dgdimick/ARC-164-DCS-Display/PCBs/v1.0-Prototype/LED-Subboard/README.md

# ARC-164 LED Sub Board — Version 1.0 withdrawn; current version 1.2 published

**Last updated: November 10, 2026 at 6:01 PM MST (America/Denver)**

**LED Sub Board v1.2 is now published for Main Board v1.2.** I printed the latest mockup at **100%** and it passed the fit test, including **frequency and channel LED alignment and J20 connector/cable clearance**. The final layout keeps the **FREQ LEDs up 0.5 mm**, the **channel LEDs up 0.5 mm with their earlier 0.5 mm leftward adjustment**, and **J20 up 2 mm total** from the previous mounting position. The **0.75 mm gaps, 6 mm display bodies and tested 8 mm mounting stack** remain unchanged. **Use Main Board v1.2 with LED Sub Board v1.2; older Sub Boards do not match this Main Board. Assembled electrical testing is still pending.**

The older files remain withdrawn. Use [Sub Board v1.2](../../v1.2/LED-Subboard/README.md), which matches Main Board v1.2 and has passed physical mockup fitting.

[PCB status and available boards](../../README.md)
