dgdimick/ARC-164-DCS-Display/PCBs/v1.0-Prototype/LED-Subboard/Manufacturing/Drill-Report.txt

Drill report for LED Subboard.kicad_pcb
Created on 2026-11-07T11:51:38

Copper Layer Stackup:
    =============================================================
    L1 :  F.Cu                      front
    L2 :  B.Cu                      back

Drill file 'LED Subboard-PTH.drl' contains
    plated through holes:
    =============================================================
    T1  0.300mm  0.0118"  (83 holes))
    T2  1.000mm  0.0394"  (120 holes))

    Total plated holes count 203

Drill file 'LED Subboard-NPTH.drl' contains
    unplated through holes:
    =============================================================

    Total unplated holes count 0
