dgdimick/ARC-164-DCS-Display/PCBs/v1.0-Prototype/Main-Board/Manufacturing/Drill-Report.txt

Drill report for Main Board.kicad_pcb
Created on 2026-11-07T12:05:29

Copper Layer Stackup:
    =============================================================
    L1 :  F.Cu                      front
    L2 :  B.Cu                      back

Drill file 'Main Board-PTH.drl' contains
    plated through holes:
    =============================================================
    T1  0.300mm  0.0118"  (20 holes))
    T2  0.800mm  0.0315"  (38 holes))
    T3  0.900mm  0.0354"  (38 holes))
    T4  1.000mm  0.0394"  (78 holes))
    T5  1.500mm  0.0591"  (18 holes))
    T6  1.700mm  0.0669"  (12 holes))
    T7  2.000mm  0.0787"  (14 holes)  (with 14 slots)

    Total plated holes count 218

Drill file 'Main Board-NPTH.drl' contains
    unplated through holes:
    =============================================================

    Total unplated holes count 0
