dgdimick/ARC-164-DCS-Display/PCBs/v1.0-Prototype/Power-Driver-Board/Manufacturing/Drill-Report.txt

Drill report for Power Driver Board.kicad_pcb
Created on 2026-11-07T11:51:38

Copper Layer Stackup:
    =============================================================
    L1 :  F.Cu                      front
    L2 :  B.Cu                      back

Drill file 'Power Driver Board-PTH.drl' contains
    plated through holes:
    =============================================================
    T1  0.300mm  0.0118"  (54 holes))
    T2  0.800mm  0.0315"  (96 holes))
    T3  1.000mm  0.0394"  (83 holes))
    T4  1.100mm  0.0433"  (62 holes))
    T5  1.600mm  0.0630"  (3 holes))

    Total plated holes count 298

Drill file 'Power Driver Board-NPTH.drl' contains
    unplated through holes:
    =============================================================
    T1  3.200mm  0.1260"  (2 holes)  (with 2 slots)

    Total unplated holes count 2
