dgdimick/ARC-164-DCS-Display/images/ARC-164-MAIN-PRESET-height-preview.png

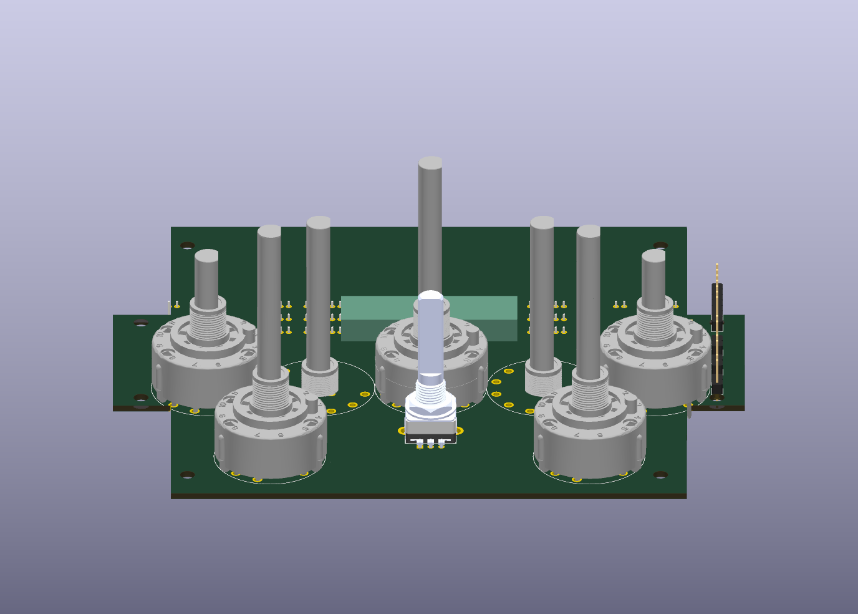
images/ARC-164-MAIN-PRESET-height-preview.png
