dgdimick/ARC-164-DCS-Display/images/ARC-164_Staggered_PCB_Mount_Concept.png

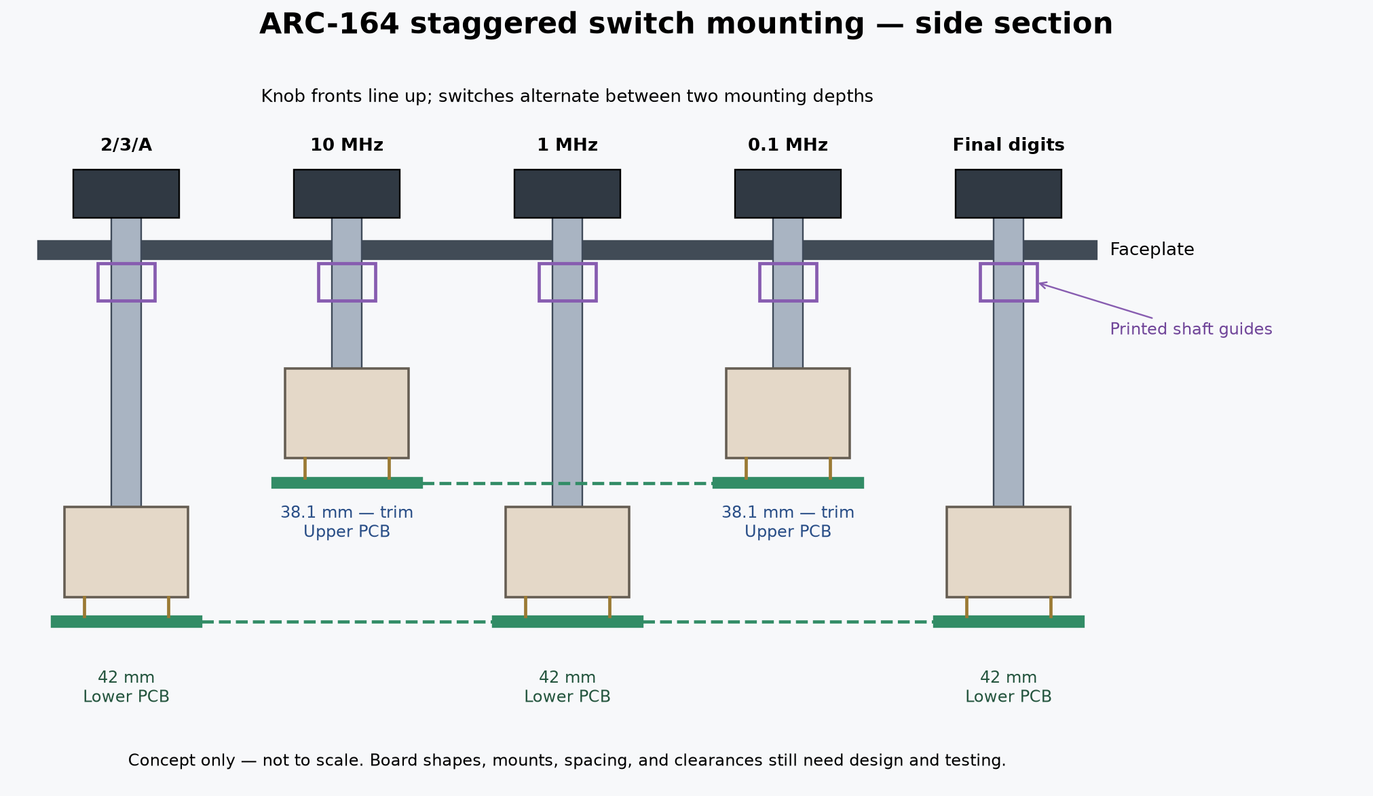
images/ARC-164_Staggered_PCB_Mount_Concept.png
