dgdimick/ARC-164-DCS-Display/images/ARC-164_Switch_PCB_Fit_Check.png

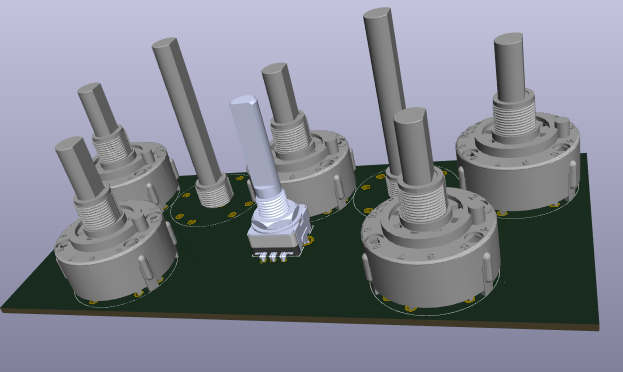
images/ARC-164_Switch_PCB_Fit_Check.png
