dgdimick/ARC-164-DCS-Display/images/PC-Flights-Six-Digit-Amber-Display-Drawing.png

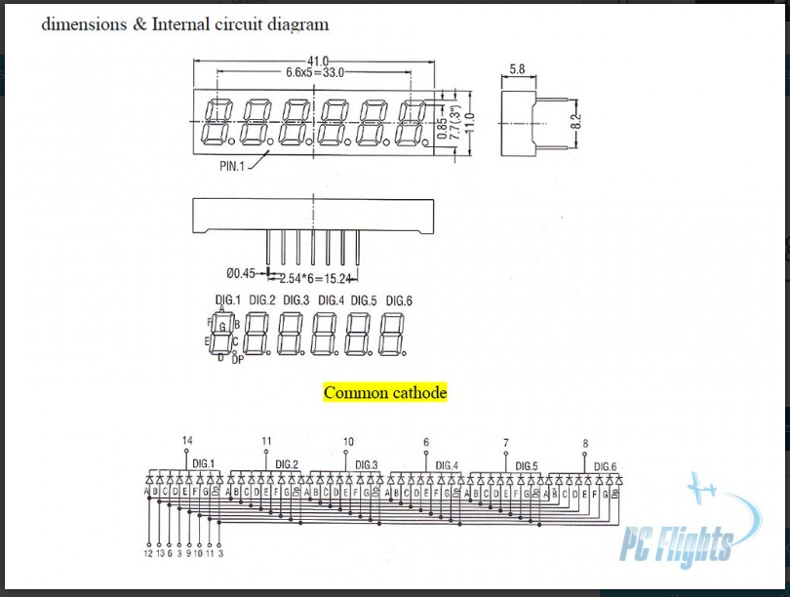
images/PC-Flights-Six-Digit-Amber-Display-Drawing.png
