dgdimick/ARC-164-DCS-Display/PCBs/v1.0-Prototype/LED-Subboard/Previews/bottom.png

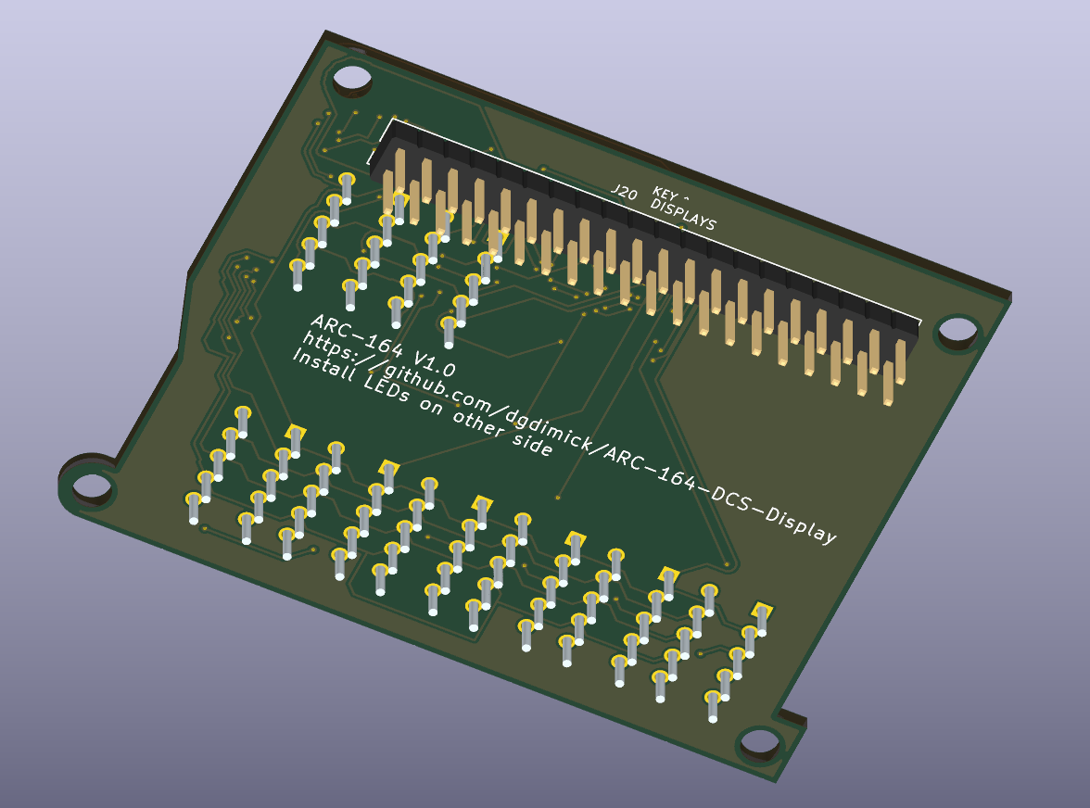
PCBs/v1.0-Prototype/LED-Subboard/Previews/bottom.png
