dgdimick/ARC-164-DCS-Display/PCBs/v1.0-Prototype/LED-Subboard/Previews/top.png

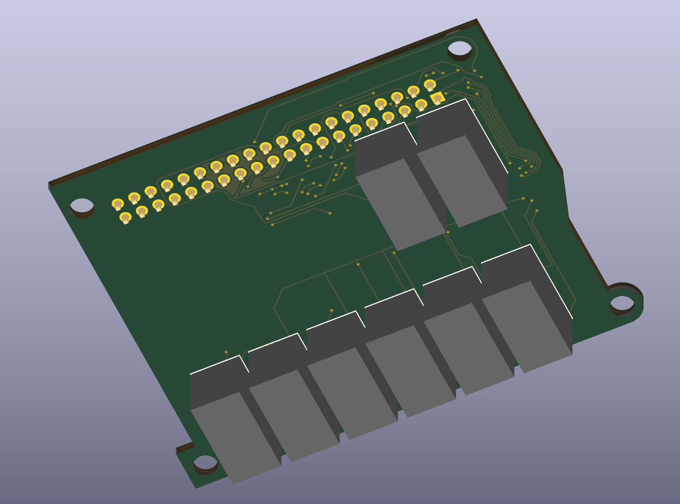
PCBs/v1.0-Prototype/LED-Subboard/Previews/top.png
