dgdimick/ARC-164-DCS-Display/PCBs/v1.0-Prototype/Main-Board/Previews/bottom.png

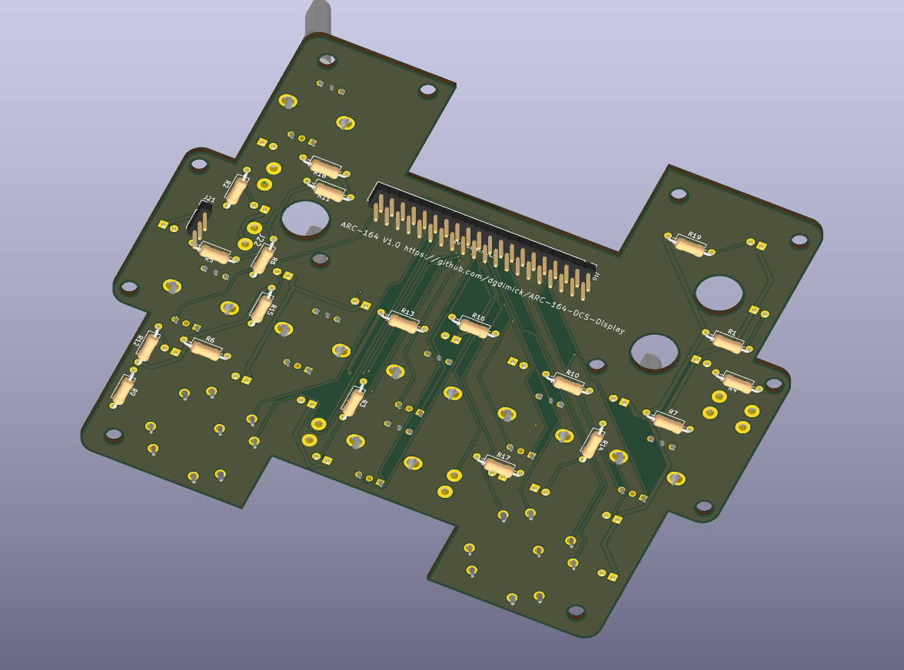
PCBs/v1.0-Prototype/Main-Board/Previews/bottom.png
