dgdimick/ARC-164-DCS-Display/PCBs/v1.2/LED-Subboard/Assembly/BOM.csv

Refs | Value | Footprint | Qty | DNP
DS1 | QBSLDIW301GR | ARC164_WhiteDisplays:QBSLDIW301GR | 1
DS2 | QBSLDIW301GR | ARC164_WhiteDisplays:QBSLDIW301GR | 1
DS3 | QBSLDIW301GR | ARC164_WhiteDisplays:QBSLDIW301GR | 1
DS4 | QBSLDIW301GR | ARC164_WhiteDisplays:QBSLDIW301GR | 1
DS5 | QBSLDIW301GR | ARC164_WhiteDisplays:QBSLDIW301GR | 1
DS6 | QBSLDIW301GR | ARC164_WhiteDisplays:QBSLDIW301GR | 1
DS7 | QBSLDIW301GR | ARC164_WhiteDisplays:QBSLDIW301GR | 1
DS8 | QBSLDIW301GR | ARC164_WhiteDisplays:QBSLDIW301GR | 1
J20 | TSW-120-07-L-D - DISPLAYS | Connector_PinHeader_2.54mm:PinHeader_2x20_P2.54mm_Vertical | 1
