dgdimick/ARC-164-DCS-Display/PCBs/v1.2/Main-Board/Assembly/BOM.csv

Refs | Value | Footprint | Qty | DNP
D1 | WP710A10SGD | ARC164_Backlight:LED_D3.0mm_Green | 1
D2 | WP710A10SGD | ARC164_Backlight:LED_D3.0mm_Green | 1
D3 | WP710A10SGD | ARC164_Backlight:LED_D3.0mm_Green | 1
D4 | WP710A10SGD | ARC164_Backlight:LED_D3.0mm_Green | 1
D5 | WP710A10SGD | ARC164_Backlight:LED_D3.0mm_Green | 1
D6 | WP710A10SGD | ARC164_Backlight:LED_D3.0mm_Green | 1
D7 | WP710A10SGD | ARC164_Backlight:LED_D3.0mm_Green | 1
D8 | WP710A10SGD | ARC164_Backlight:LED_D3.0mm_Green | 1
D9 | WP710A10SGD | ARC164_Backlight:LED_D3.0mm_Green | 1
D10 | WP710A10SGD | ARC164_Backlight:LED_D3.0mm_Green | 1
D11 | WP710A10SGD | ARC164_Backlight:LED_D3.0mm_Green | 1
D12 | WP710A10SGD | ARC164_Backlight:LED_D3.0mm_Green | 1
D13 | WP710A10SGD | ARC164_Backlight:LED_D3.0mm_Green | 1
D14 | WP710A10SGD | ARC164_Backlight:LED_D3.0mm_Green | 1
D15 | WP710A10SGD | ARC164_Backlight:LED_D3.0mm_Green | 1
D16 | WP710A10SGD | ARC164_Backlight:LED_D3.0mm_Green | 1
D17 | WP710A10SGD | ARC164_Backlight:LED_D3.0mm_Green | 1
D18 | WP710A10SGD | ARC164_Backlight:LED_D3.0mm_Green | 1
D19 | WP710A10SGD | ARC164_Backlight:LED_D3.0mm_Green | 1
J10 | Controls cable to Power Driver Board J10 | Connector_PinHeader_2.54mm:PinHeader_2x20_P2.54mm_Vertical | 1
J21 | Backlight power from driver J21 | Connector_PinHeader_2.54mm:PinHeader_1x03_P2.54mm_Vertical | 1
J22 | Auxiliary resistor-limited backlight output | ARC164_WirePads:WireSolderPads_1x02_P4.6mm_D1.7mm_18AWG | 1
R1 | 330 | Resistor_THT:R_Axial_DIN0207_L6.3mm_D2.5mm_P10.16mm_Horizontal | 1
R2 | 330 | Resistor_THT:R_Axial_DIN0207_L6.3mm_D2.5mm_P10.16mm_Horizontal | 1
R3 | 330 | Resistor_THT:R_Axial_DIN0207_L6.3mm_D2.5mm_P10.16mm_Horizontal | 1
R4 | 330 | Resistor_THT:R_Axial_DIN0207_L6.3mm_D2.5mm_P10.16mm_Horizontal | 1
R5 | 330 | Resistor_THT:R_Axial_DIN0207_L6.3mm_D2.5mm_P10.16mm_Horizontal | 1
R6 | 330 | Resistor_THT:R_Axial_DIN0207_L6.3mm_D2.5mm_P10.16mm_Horizontal | 1
R7 | 330 | Resistor_THT:R_Axial_DIN0207_L6.3mm_D2.5mm_P10.16mm_Horizontal | 1
R8 | 330 | Resistor_THT:R_Axial_DIN0207_L6.3mm_D2.5mm_P10.16mm_Horizontal | 1
R9 | 330 | Resistor_THT:R_Axial_DIN0207_L6.3mm_D2.5mm_P10.16mm_Horizontal | 1
R10 | 330 | Resistor_THT:R_Axial_DIN0207_L6.3mm_D2.5mm_P10.16mm_Horizontal | 1
R11 | 330 | Resistor_THT:R_Axial_DIN0207_L6.3mm_D2.5mm_P10.16mm_Horizontal | 1
R12 | 330 | Resistor_THT:R_Axial_DIN0207_L6.3mm_D2.5mm_P10.16mm_Horizontal | 1
R13 | 330 | Resistor_THT:R_Axial_DIN0207_L6.3mm_D2.5mm_P10.16mm_Horizontal | 1
R14 | 330 | Resistor_THT:R_Axial_DIN0207_L6.3mm_D2.5mm_P10.16mm_Horizontal | 1
R15 | 330 | Resistor_THT:R_Axial_DIN0207_L6.3mm_D2.5mm_P10.16mm_Horizontal | 1
R16 | 330 | Resistor_THT:R_Axial_DIN0207_L6.3mm_D2.5mm_P10.16mm_Horizontal | 1
R17 | 330 | Resistor_THT:R_Axial_DIN0207_L6.3mm_D2.5mm_P10.16mm_Horizontal | 1
R18 | 330 | Resistor_THT:R_Axial_DIN0207_L6.3mm_D2.5mm_P10.16mm_Horizontal | 1
R19 | 330 | Resistor_THT:R_Axial_DIN0207_L6.3mm_D2.5mm_P10.16mm_Horizontal | 1
SW1 | PEC11R-4230F-S0024 | ARC210_Encoders:PEC11R4230FS0024 | 1
SW2 | PEC11R-4230F-S0024 | ARC210_Encoders:PEC11R4230FS0024 | 1
SW3 | PEC11R-4230F-S0024 | ARC210_Encoders:PEC11R4230FS0024 | 1
SW4 | PEC11R-4230F-S0024 | ARC210_Encoders:PEC11R4230FS0024 | 1
SW5 | PEC11R-4230F-S0024 | ARC210_Encoders:PEC11R4230FS0024 | 1
SW6 | PEC11R-4230F-S0024 | ARC210_Encoders:PEC11R4230FS0024 | 1
SW7 | A12505RNCQ | ARC164_Switches:A12505RNCQ | 1
SW8 | A12505RNCQ | ARC164_Switches:A12505RNCQ | 1
SW9 | PEC11R-4230F-S0024 | ARC210_Encoders:PEC11R4230FS0024 | 1
SW10 | TONE - wire solder pads | ARC164_WirePads:WireSolderPads_1x02_P4.6mm_D1.7mm_18AWG | 1
SW11 | SQL - wire solder pads | ARC164_WirePads:WireSolderPads_1x02_P4.6mm_D1.7mm_18AWG | 1
SW12 | LOAD (magnetic reed) - wire solder pads | ARC164_WirePads:WireSolderPads_1x02_P4.6mm_D1.7mm_18AWG | 1
SW13 | TEST_DISPLAY - wire solder pads | ARC164_WirePads:WireSolderPads_1x02_P4.6mm_D1.7mm_18AWG | 1
SW14 | STATUS - wire solder pads | ARC164_WirePads:WireSolderPads_1x02_P4.6mm_D1.7mm_18AWG | 1
