dgdimick/ARC-164-DCS-Display/PCBs/v1.0-Prototype/LED-Subboard/Assembly/BOM.csv

Refs | Value | Footprint | Qty | DNP
DS1-DS6 | SC36-11SURKWA | Kingbright_SC36:SC3611SURKWA_Frequency | 6
DS7,DS8 | SC36-11SURKWA | Kingbright_SC36:SC3611SURKWA | 2
J20 | TSW-120-07-L-D - DISPLAYS | Connector_PinHeader_2.54mm:PinHeader_2x20_P2.54mm_Vertical | 1
