dgdimick/ARC-164-DCS-Display/PCBs/v1.0-Prototype/Main-Board/Assembly/BOM.csv

Refs | Value | Footprint | Qty | DNP
D1-D19 | WP710A10SGD | ARC164_Backlight:LED_D3.0mm_Green | 19
J10 | Controls cable to Power Driver Board J10 | Connector_PinHeader_2.54mm:PinHeader_2x20_P2.54mm_Vertical | 1
J21 | Backlight power from driver J21 | Connector_PinHeader_2.54mm:PinHeader_1x03_P2.54mm_Vertical | 1
J22 | Auxiliary resistor-limited backlight output | ARC164_WirePads:WireSolderPads_1x02_P4.6mm_D1.7mm_18AWG | 1
R1-R19 | 330 | Resistor_THT:R_Axial_DIN0207_L6.3mm_D2.5mm_P10.16mm_Horizontal | 19
SW1-SW6,SW9 | PEC11R-4230F-S0024 | ARC210_Encoders:PEC11R4230FS0024 | 7
SW7,SW8 | A12505RNCQ | ARC164_Switches:A12505RNCQ | 2
SW10 | TONE - wire solder pads | ARC164_WirePads:WireSolderPads_1x02_P4.6mm_D1.7mm_18AWG | 1
SW11 | SQL - wire solder pads | ARC164_WirePads:WireSolderPads_1x02_P4.6mm_D1.7mm_18AWG | 1
SW12 | LOAD (magnetic reed) - wire solder pads | ARC164_WirePads:WireSolderPads_1x02_P4.6mm_D1.7mm_18AWG | 1
SW13 | TEST_DISPLAY - wire solder pads | ARC164_WirePads:WireSolderPads_1x02_P4.6mm_D1.7mm_18AWG | 1
SW14 | STATUS - wire solder pads | ARC164_WirePads:WireSolderPads_1x02_P4.6mm_D1.7mm_18AWG | 1
