dgdimick/ARC-164-DCS-Display/PCBs/v1.0-Prototype/Power-Driver-Board/Assembly/BOM.csv

Refs | Value | Footprint | Qty | DNP
C11,C13,C15 | 100nF | Capacitor_THT:C_Disc_D5.0mm_W2.5mm_P5.00mm | 3
C12,C14 | 10uF / 10V | Capacitor_THT:CP_Radial_D5.0mm_P2.00mm | 2
J10 | Controls cable to Main Board J10 | Connector_PinHeader_2.54mm:PinHeader_2x20_P2.54mm_Vertical | 1
J11 | PJ-102AH | 5V ONLY, center + | ARC164_Power:BarrelJack_CUI_PJ-102AH_Horizontal | 1
J20 | TSW-120-07-L-D - DISPLAYS | Connector_PinHeader_2.54mm:PinHeader_2x20_P2.54mm_Vertical | 1
J21 | Backlight power to Main Board J21 | Connector_PinHeader_2.54mm:PinHeader_1x03_P2.54mm_Vertical | 1
Q1 | IRLZ44N | Package_TO_SOT_THT:TO-220-3_Vertical | 1
R11,R12 | 68k | Resistor_THT:R_Axial_DIN0207_L6.3mm_D2.5mm_P10.16mm_Horizontal | 2
R13 | 220 | Resistor_THT:R_Axial_DIN0207_L6.3mm_D2.5mm_P10.16mm_Horizontal | 1
R14,R21-R24 | 100k | Resistor_THT:R_Axial_DIN0207_L6.3mm_D2.5mm_P10.16mm_Horizontal | 5
U1 | Teensy 4.1 - USB powered | teensy:Teensy41 | 1
U11,U12 | MAX7219 | Package_DIP:DIP-24_W7.62mm | 2
U13 | 74AHCT125 | Package_DIP:DIP-14_W7.62mm | 1
