dgdimick/ARC-164-DCS-Display/PCBs/v1.0-Prototype/Docs/Connector-Pin-Comparison.csv

Connector | Pin | Board A | Signal A | Board B | Signal B | Match
J10 | 1 | main | GND | power | GND | True
J10 | 2 | main | NC | power | NC | True
J10 | 3 | main | NC | power | NC | True
J10 | 4 | main | NC | power | NC | True
J10 | 5 | main | NC | power | NC | True
J10 | 6 | main | FREQ1_A | power | FREQ1_A | True
J10 | 7 | main | FREQ1_B | power | FREQ1_B | True
J10 | 8 | main | FREQ2_A | power | FREQ2_A | True
J10 | 9 | main | FREQ2_B | power | FREQ2_B | True
J10 | 10 | main | FREQ3_A | power | FREQ3_A | True
J10 | 11 | main | FREQ3_B | power | FREQ3_B | True
J10 | 12 | main | FREQ4_A | power | FREQ4_A | True
J10 | 13 | main | FREQ4_B | power | FREQ4_B | True
J10 | 14 | main | FREQ5_A | power | FREQ5_A | True
J10 | 15 | main | FREQ5_B | power | FREQ5_B | True
J10 | 16 | main | CHANNEL_A | power | CHANNEL_A | True
J10 | 17 | main | CHANNEL_B | power | CHANNEL_B | True
J10 | 18 | main | VOL_A | power | VOL_A | True
J10 | 19 | main | VOL_B | power | VOL_B | True
J10 | 20 | main | MAIN_POS1 | power | MAIN_POS1 | True
J10 | 21 | main | MAIN_POS2 | power | MAIN_POS2 | True
J10 | 22 | main | MAIN_POS3 | power | MAIN_POS3 | True
J10 | 23 | main | MAIN_POS4 | power | MAIN_POS4 | True
J10 | 24 | main | PRESET_POS1 | power | PRESET_POS1 | True
J10 | 25 | main | PRESET_POS2 | power | PRESET_POS2 | True
J10 | 26 | main | PRESET_POS3 | power | PRESET_POS3 | True
J10 | 27 | main | TONE | power | TONE | True
J10 | 28 | main | SQL | power | SQL | True
J10 | 29 | main | LOAD | power | LOAD | True
J10 | 30 | main | TEST_DISPLAY | power | TEST_DISPLAY | True
J10 | 31 | main | STATUS | power | STATUS | True
J10 | 32 | main | GND | power | GND | True
J10 | 33 | main | NC | power | NC | True
J10 | 34 | main | NC | power | NC | True
J10 | 35 | main | NC | power | NC | True
J10 | 36 | main | NC | power | NC | True
J10 | 37 | main | NC | power | NC | True
J10 | 38 | main | NC | power | NC | True
J10 | 39 | main | NC | power | NC | True
J10 | 40 | main | NC | power | NC | True
J20 | 1 | power | SEG1_A | led | SEG1_A | True
J20 | 2 | power | SEG1_B | led | SEG1_B | True
J20 | 3 | power | SEG1_C | led | SEG1_C | True
J20 | 4 | power | SEG1_D | led | SEG1_D | True
J20 | 5 | power | SEG1_E | led | SEG1_E | True
J20 | 6 | power | SEG1_F | led | SEG1_F | True
J20 | 7 | power | SEG1_G | led | SEG1_G | True
J20 | 8 | power | SEG1_DP | led | SEG1_DP | True
J20 | 9 | power | DIG1_0 | led | DIG1_0 | True
J20 | 10 | power | DIG1_1 | led | DIG1_1 | True
J20 | 11 | power | DIG1_2 | led | DIG1_2 | True
J20 | 12 | power | DIG1_3 | led | DIG1_3 | True
J20 | 13 | power | DIG1_4 | led | DIG1_4 | True
J20 | 14 | power | DIG1_5 | led | DIG1_5 | True
J20 | 15 | power | SEG2_A | led | SEG2_A | True
J20 | 16 | power | SEG2_B | led | SEG2_B | True
J20 | 17 | power | SEG2_C | led | SEG2_C | True
J20 | 18 | power | SEG2_D | led | SEG2_D | True
J20 | 19 | power | SEG2_E | led | SEG2_E | True
J20 | 20 | power | SEG2_F | led | SEG2_F | True
J20 | 21 | power | SEG2_G | led | SEG2_G | True
J20 | 22 | power | SEG2_DP | led | SEG2_DP | True
J20 | 23 | power | DIG2_0 | led | DIG2_0 | True
J20 | 24 | power | DIG2_1 | led | DIG2_1 | True
J20 | 25 | power | NC | led | NC | True
J20 | 26 | power | NC | led | NC | True
J20 | 27 | power | GND | led | GND | True
J20 | 28 | power | GND | led | GND | True
J20 | 29 | power | LED_5V | led | LED_5V | True
J20 | 30 | power | LED_5V | led | LED_5V | True
J20 | 31 | power | BACKLIGHT_RETURN | led | BACKLIGHT_RETURN | True
J20 | 32 | power | BACKLIGHT_RETURN | led | BACKLIGHT_RETURN | True
J20 | 33 | power | NC | led | NC | True
J20 | 34 | power | NC | led | NC | True
J20 | 35 | power | NC | led | NC | True
J20 | 36 | power | NC | led | NC | True
J20 | 37 | power | NC | led | NC | True
J20 | 38 | power | NC | led | NC | True
J20 | 39 | power | NC | led | NC | True
J20 | 40 | power | NC | led | NC | True
J21 | 1 | main | LED_5V | power | LED_5V | True
J21 | 2 | main | BACKLIGHT_RETURN | power | BACKLIGHT_RETURN | True
J21 | 3 | main | GND | power | GND | True
