dgdimick/ARC-164-DCS-Display/PCBs/v1.2/Main-Board/STLs/ARC-164_Main_Board_v1.2_100pct.stl

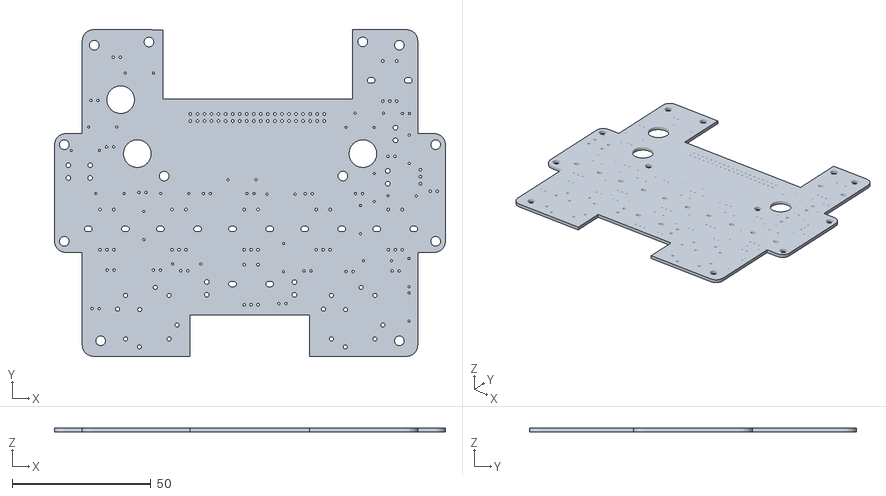
[picture p18: CAD file, 2026-11-10]
PCBs/v1.2/Main-Board/STLs/ARC-164_Main_Board_v1.2_100pct.stl
141.0 x 117.8 x 1.51
