dgdimick/ARC-164-DCS-Display/PCBs/v1.0-Prototype/LED-Subboard/Project/Models/SC36-11SURKWA.stp

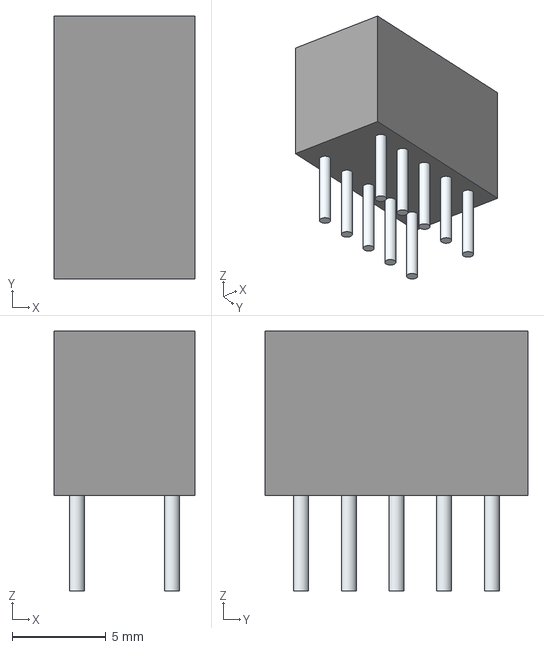
[picture p19: CAD file, 2026-11-07]
PCBs/v1.0-Prototype/LED-Subboard/Project/Models/SC36-11SURKWA.stp
7.50 x 14.0 x 13.8 mm
Leads
