dgdimick/ARC-164-DCS-Display/PCBs/v1.0-Prototype/Power-Driver-Board/Project/Models/PJ-102AH.step

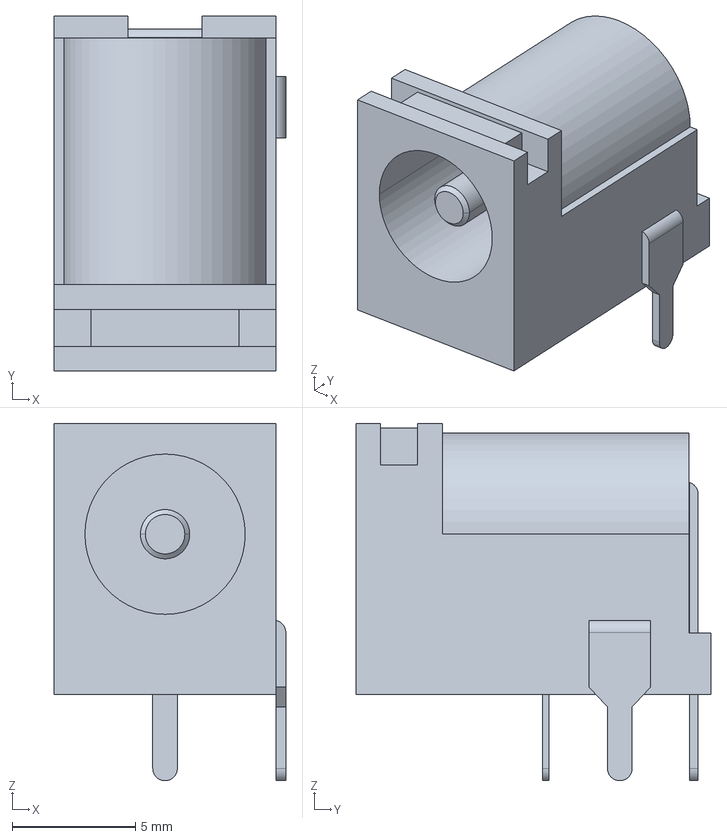
[picture p20: CAD file, 2026-11-07]
PCBs/v1.0-Prototype/Power-Driver-Board/Project/Models/PJ-102AH.step
9.40 x 14.4 x 14.5 mm
