dgdimick/ARC-164-DCS-Display/PCBs/v1.2/LED-Subboard/Project/Models/QBSLDIW301GR_MeasuredBody.step

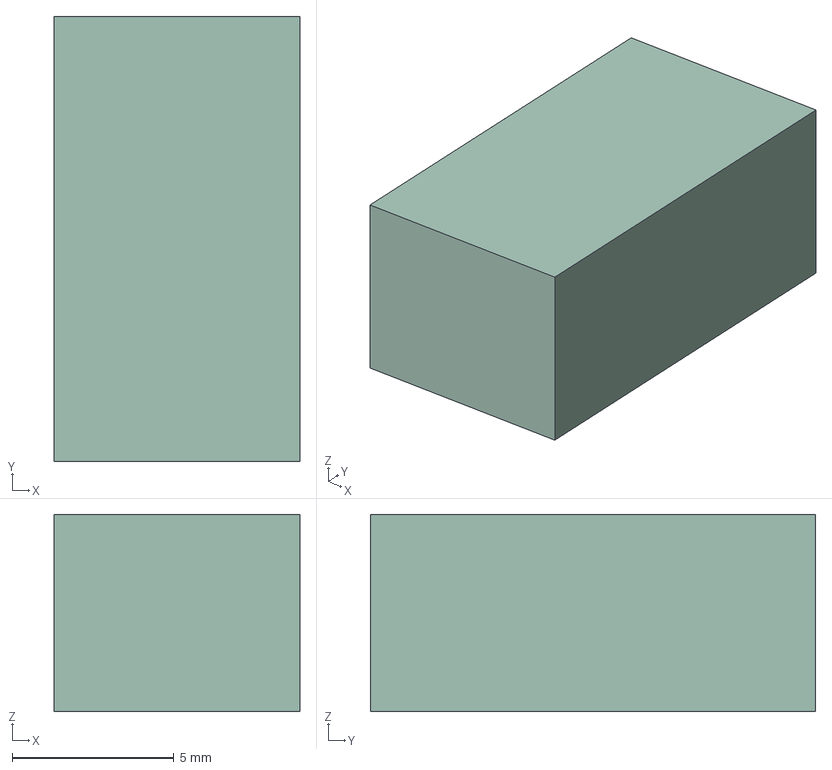
[picture p21: CAD file, 2026-11-11]
PCBs/v1.2/LED-Subboard/Project/Models/QBSLDIW301GR_MeasuredBody.step
7.60 x 13.8 x 6.10 mm
