dgdimick/ARC-164-DCS-Display/PCBs/v1.2/LED-Subboard/STLs/ARC-164_LED_Subboard_v1.2_100pct.stl

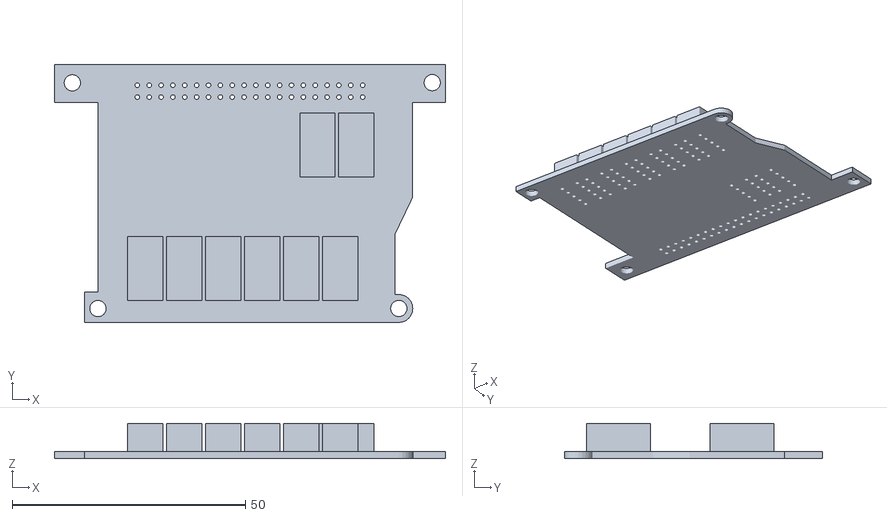
[picture p22: CAD file, 2026-11-11]
PCBs/v1.2/LED-Subboard/STLs/ARC-164_LED_Subboard_v1.2_100pct.stl
83.8 x 55.3 x 7.51
