dgdimick/ARC-164-DCS-Display/PCBs/v1.2/Main-Board/Project/Models/PEC11R-4230F-S0024-30mm-sizing.stp

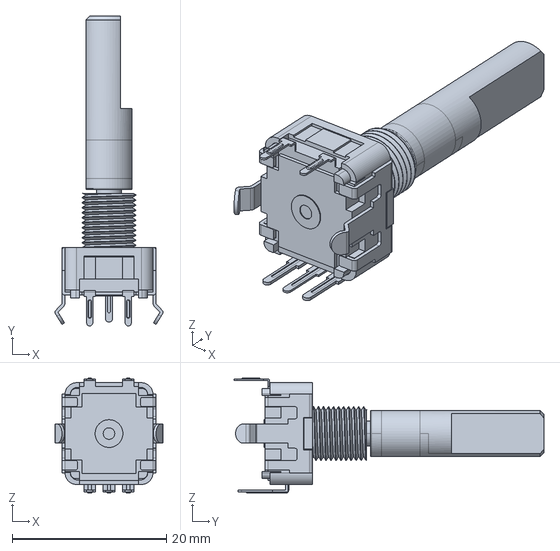
[picture p23: CAD file, 2026-11-10]
PCBs/v1.2/Main-Board/Project/Models/PEC11R-4230F-S0024-30mm-sizing.stp
14.0 x 40.2 x 14.9 mm
