dgdimick/ARC-164-DCS-Display/PCBs/v1.0-Prototype/Main-Board/Project/Models/A12505RNCQ.stp

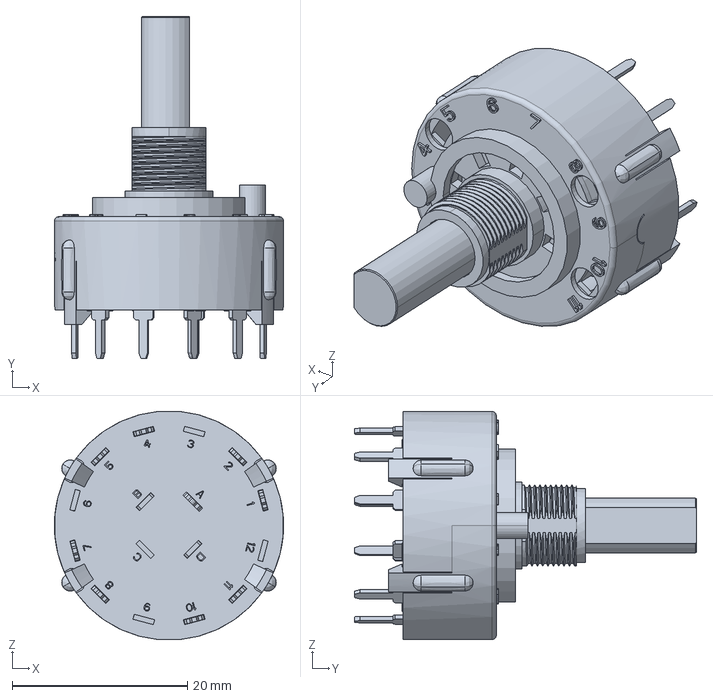
[picture p24: CAD file, 2026-11-07]
PCBs/v1.0-Prototype/Main-Board/Project/Models/A12505RNCQ.stp
26.2 x 39.1 x 26.1 mm
