dgdimick/ARC-164-DCS-Display/PCBs/v1.1/LED-Subboard/Project/Models/PEC11R-4220F-S0024-20mm-sizing.stp

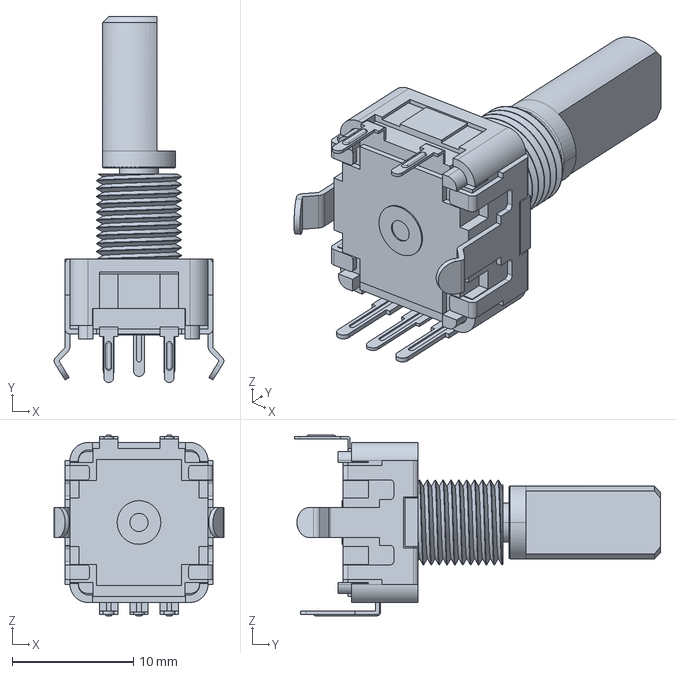
[picture p25: CAD file, 2026-11-08, an earlier design]
PCBs/v1.1/LED-Subboard/Project/Models/PEC11R-4220F-S0024-20mm-sizing.stp
14.0 x 30.2 x 14.9 mm
