dgdimick/ARC-164-DCS-Display/PCBs/v1.1/LED-Subboard/STLs/ARC-164_LED_Subboard_v1.1_100pct.stl

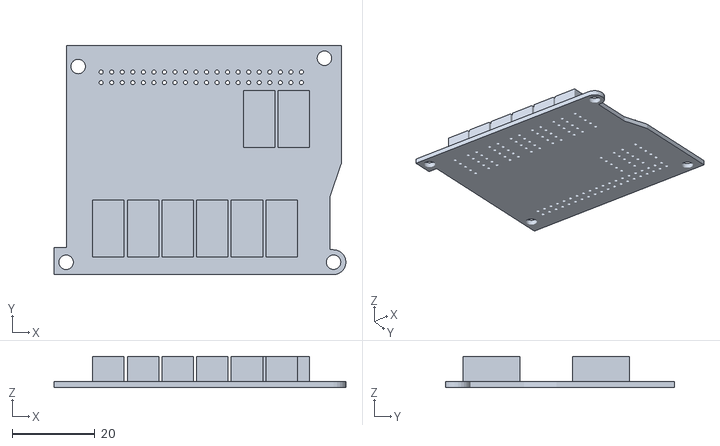
[picture p26: CAD file, 2026-11-08, an earlier design]
PCBs/v1.1/LED-Subboard/STLs/ARC-164_LED_Subboard_v1.1_100pct.stl
70.4 x 55.3 x 7.51
