dgdimick/ARC-164-DCS-Display/(list of files, cad)

Other CAD files:
PCBs/v1.1/Main-Board/STLs/ARC-164_Main_Board_v1.1_100pct.stl
PCBs/v1.1/Main-Board/Project/Models/A12505RNCQ.stp
