dgdimick/ARC-164-DCS-Display/PCBs/v1.2/LED-Subboard/Schematics/LED-Subboard-v1.2.pdf

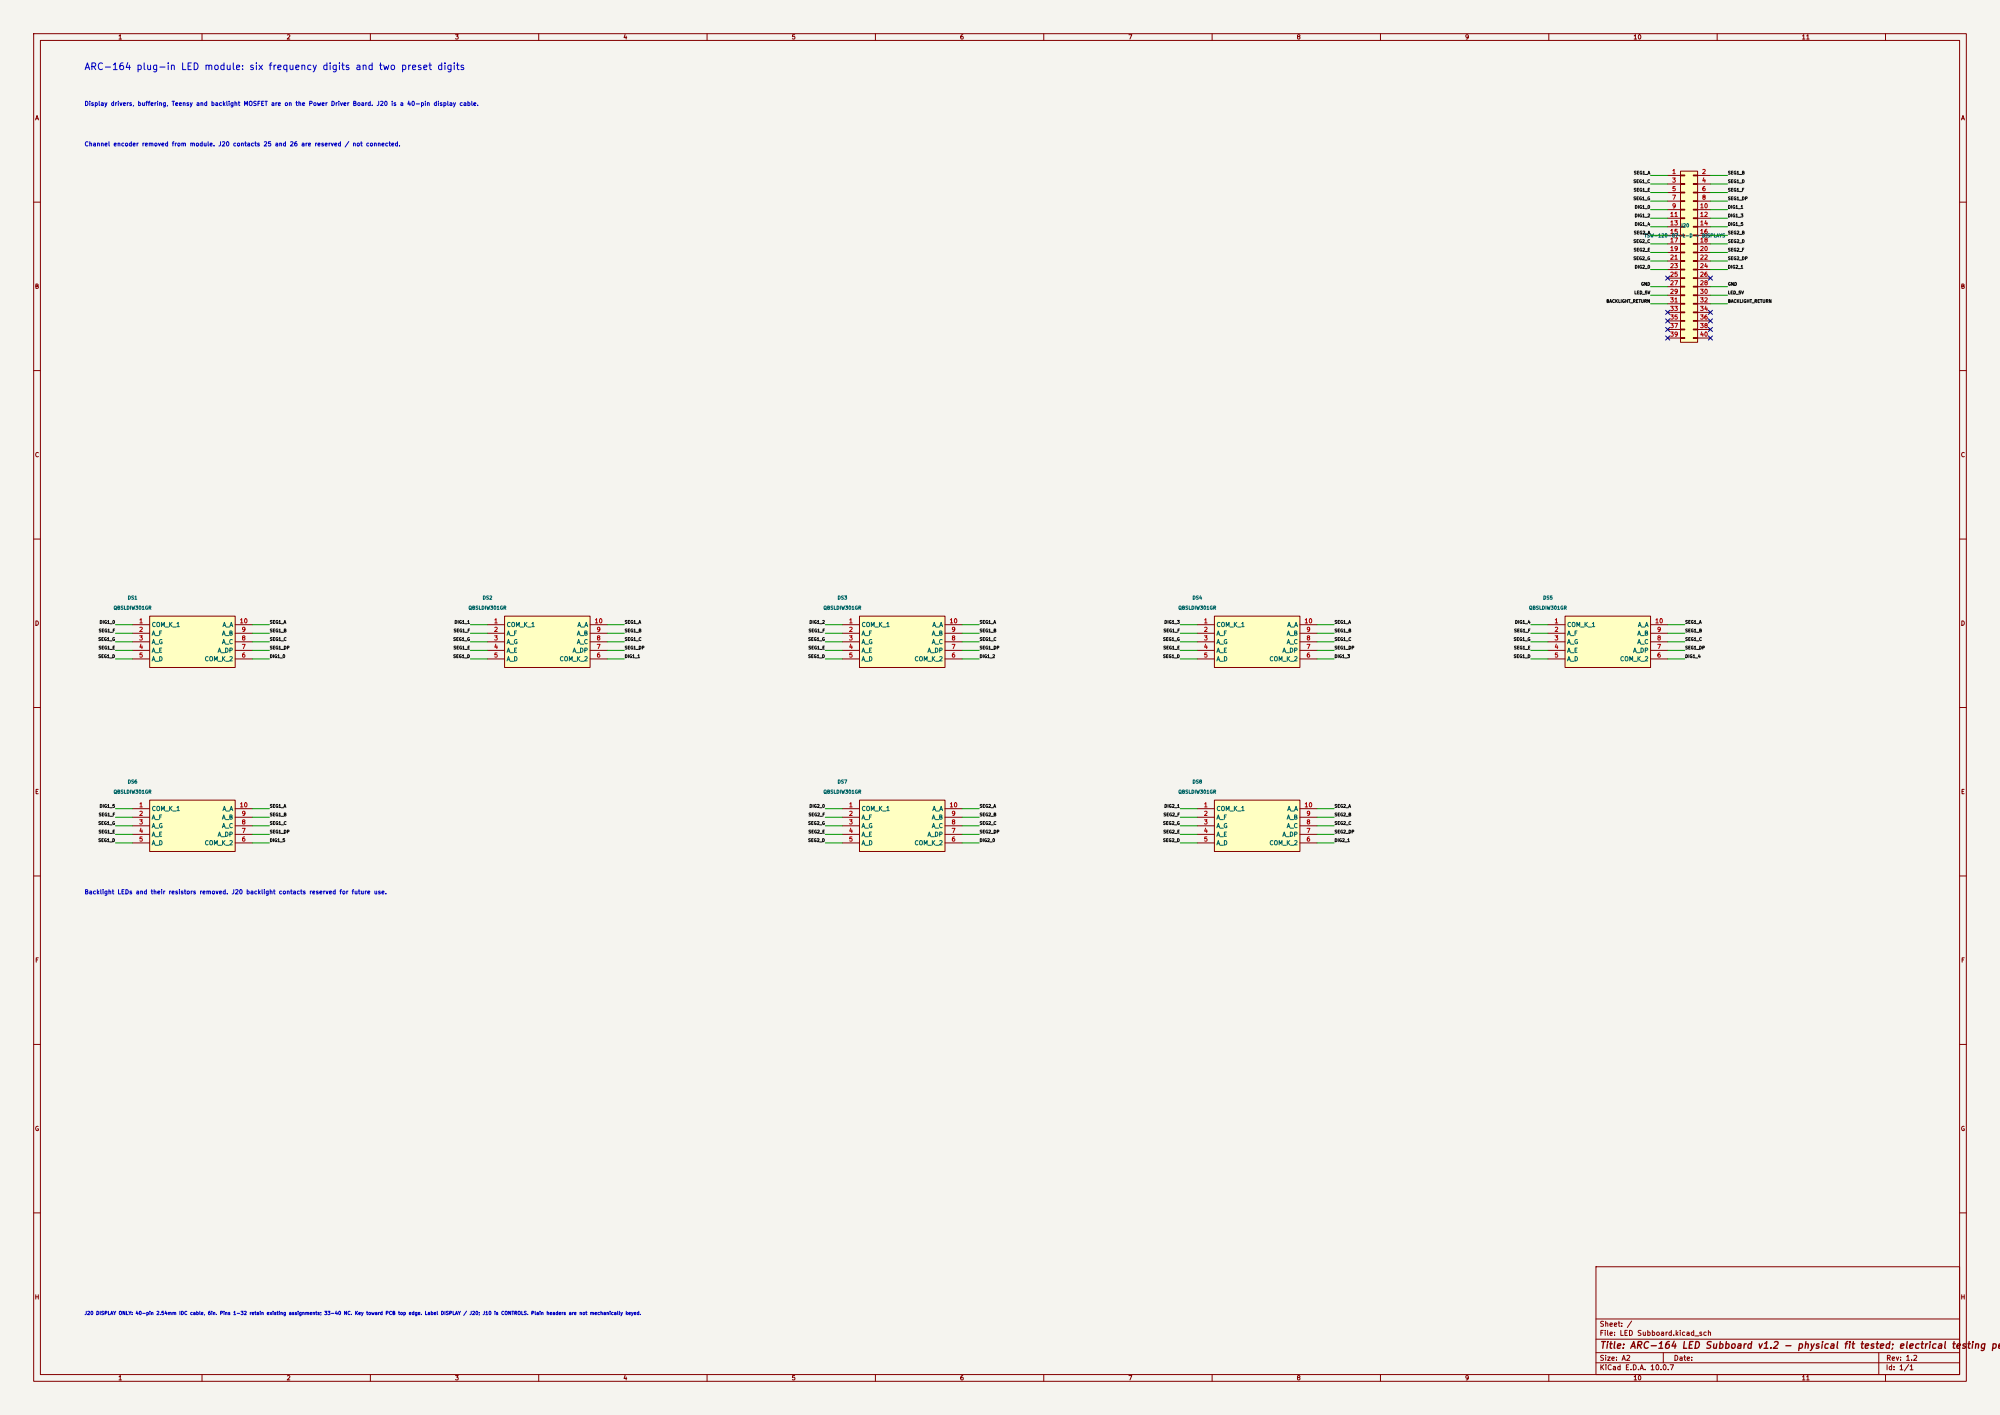
[picture p27: page 1]

ARC-164 plug-in LED module: six frequency digits and two preset digits

Display drivers, buffering, Teensy and backlight MOSFET are on the Power Driver Board. J20 is a 40-pin display cable. Channel encoder removed from module. J20 contacts 25 and 26 are reserved / not connected.

Backlight LEDs and their resistors removed. J20 backlight contacts reserved for future use.

J20 DISPLAY ONLY: 40-pin 2.54mm IDC cable, 6in. Pins 1-32 retain existing assignments; 33-40 NC. Key toward PCB top edge. Label DISPLAY / J20; J10 is CONTROLS. Plain headers are not mechanically keyed.

Sheet: /
File: LED Subboard.kicad_sch
Title: ARC-164 LED Subboard v1.2 - physical fit tested; electrical testing pending

Size: A2 | Rev: 1.2
KiCad E.D.A. 10.0.7 | Id: 1/1
