dgdimick/ARC-164-DCS-Display/PCBs/v1.2/Main-Board/Schematics/Main-Board-v1.2.pdf

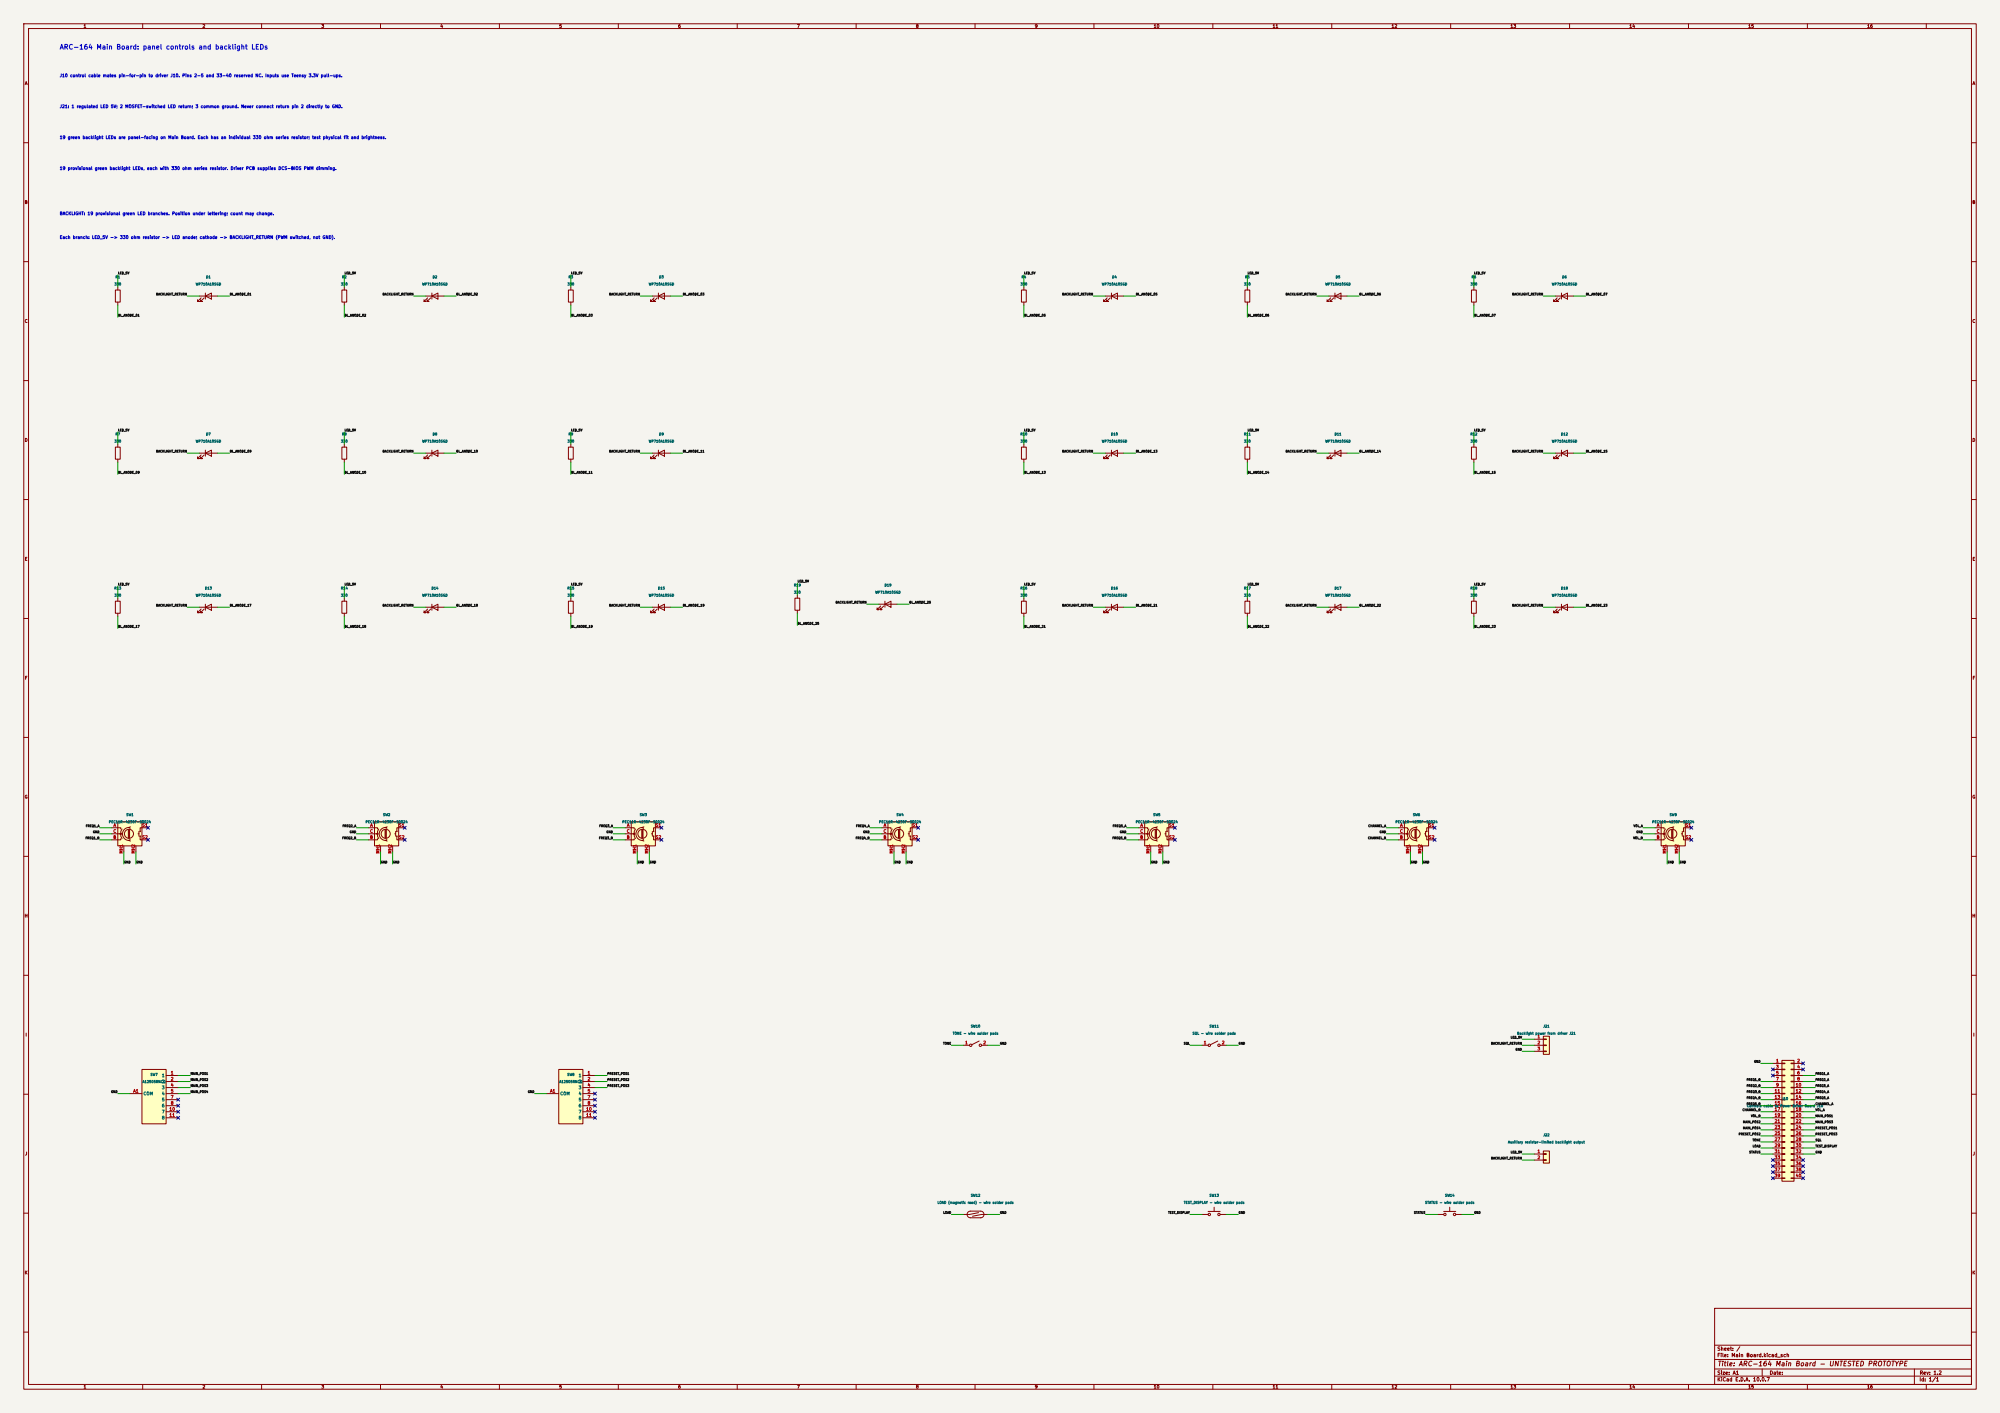
[picture p28: page 1]

ARC-164 Main Board: panel controls and backlight LEDs

J10 control cable mates pin-for-pin to driver J10. Pins 2-5 and 33-40 reserved NC. Inputs use Teensy 3.3V pull-ups. 19 provisional green backlight LEDs, each with 330 ohm series resistor. Driver PCB supplies DCS-BIOS PWM dimming. J21: 1 regulated LED 5V; 2 MOSFET-switched LED return; 3 common ground. Never connect return pin 2 directly to GND.

19 green backlight LEDs are panel-facing on Main Board. Each has an individual 330 ohm series resistor; test physical fit and brightness.

BACKLIGHT: 19 provisional green LED branches. Position under lettering; count may change. Each branch: LED_5V -> 330 ohm resistor -> LED anode; cathode -> BACKLIGHT_RETURN (PWM switched, not GND).

J21 Backlight power from driver J21

TONE - wire solder pads

SQL - wire solder pads

Auxiliary resistor-limited backlight output SW14

LOAD (magnetic reed) - wire solder pads

STATUS - wire solder pads

Sheet: /
File: Main Board.kicad_sch
Title: ARC-164 Main Board - UNTESTED PROTOTYPE

Size: A1 | Rev: 1.2
KiCad E.D.A. 10.0.7 | Id: 1/1
