dgdimick/ARC-164-DCS-Display/PCBs/v1.2/LED-Subboard/Project/LED Subboard.kicad_pcb

## KiCad design PCBs/v1.2/LED-Subboard/Project/LED Subboard.kicad_pcb (2026-11-11)

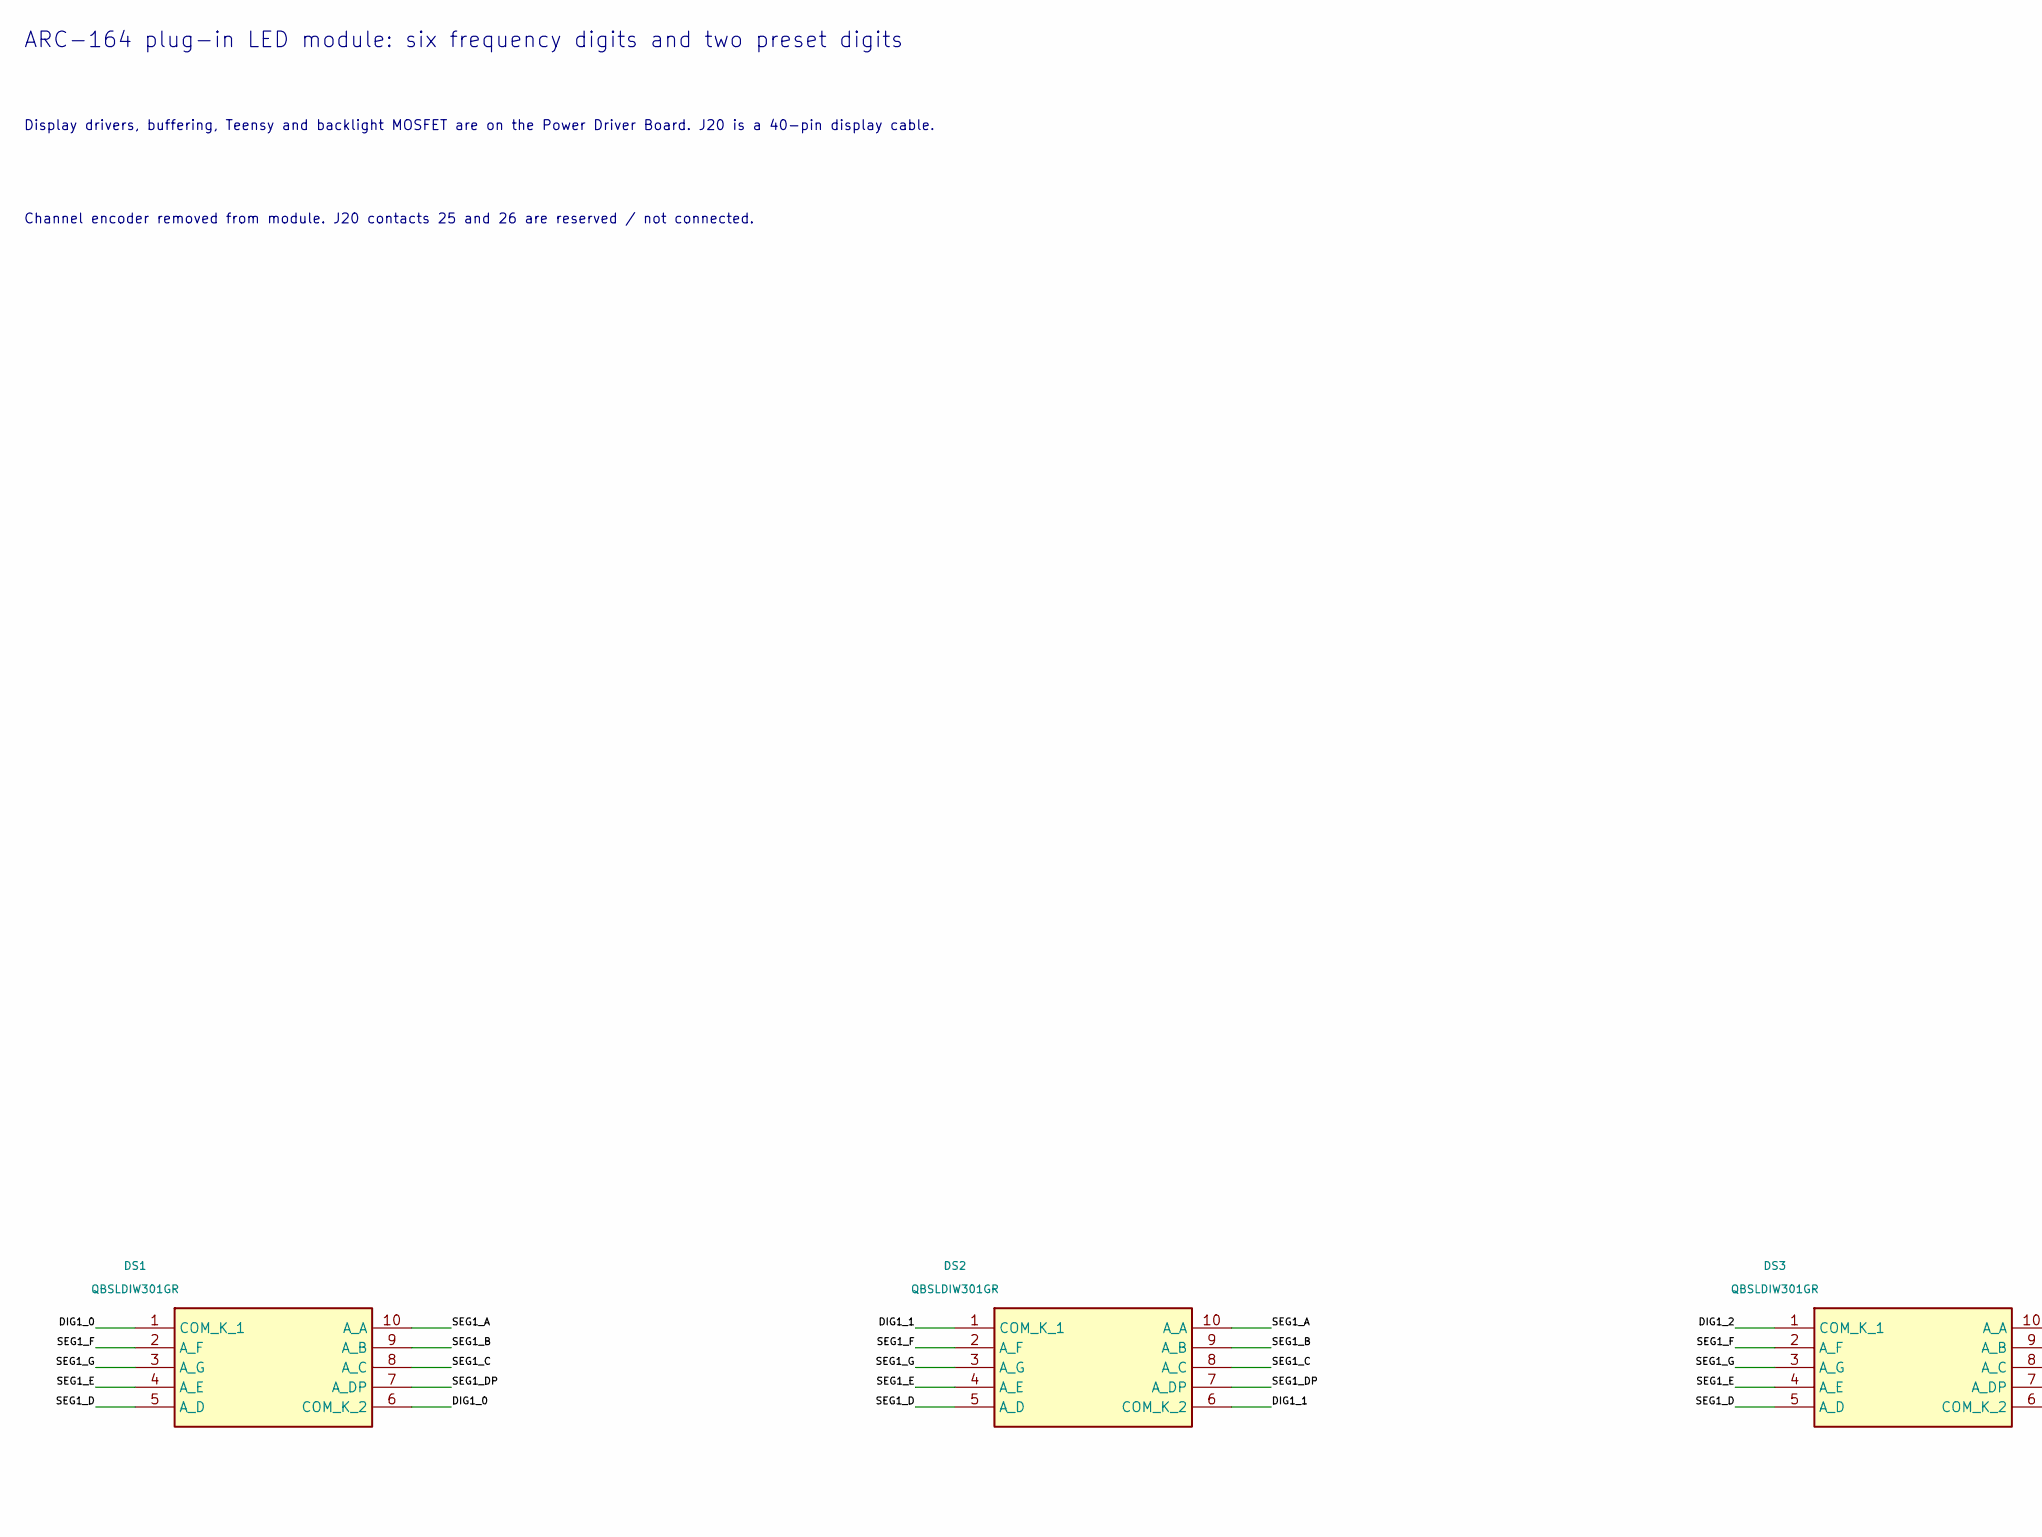
[picture p30: schematic LED Subboard.kicad_sch, ARC-164 LED Subboard v1.2 - physical fit tested; electrical…, part in row 1, column 1]

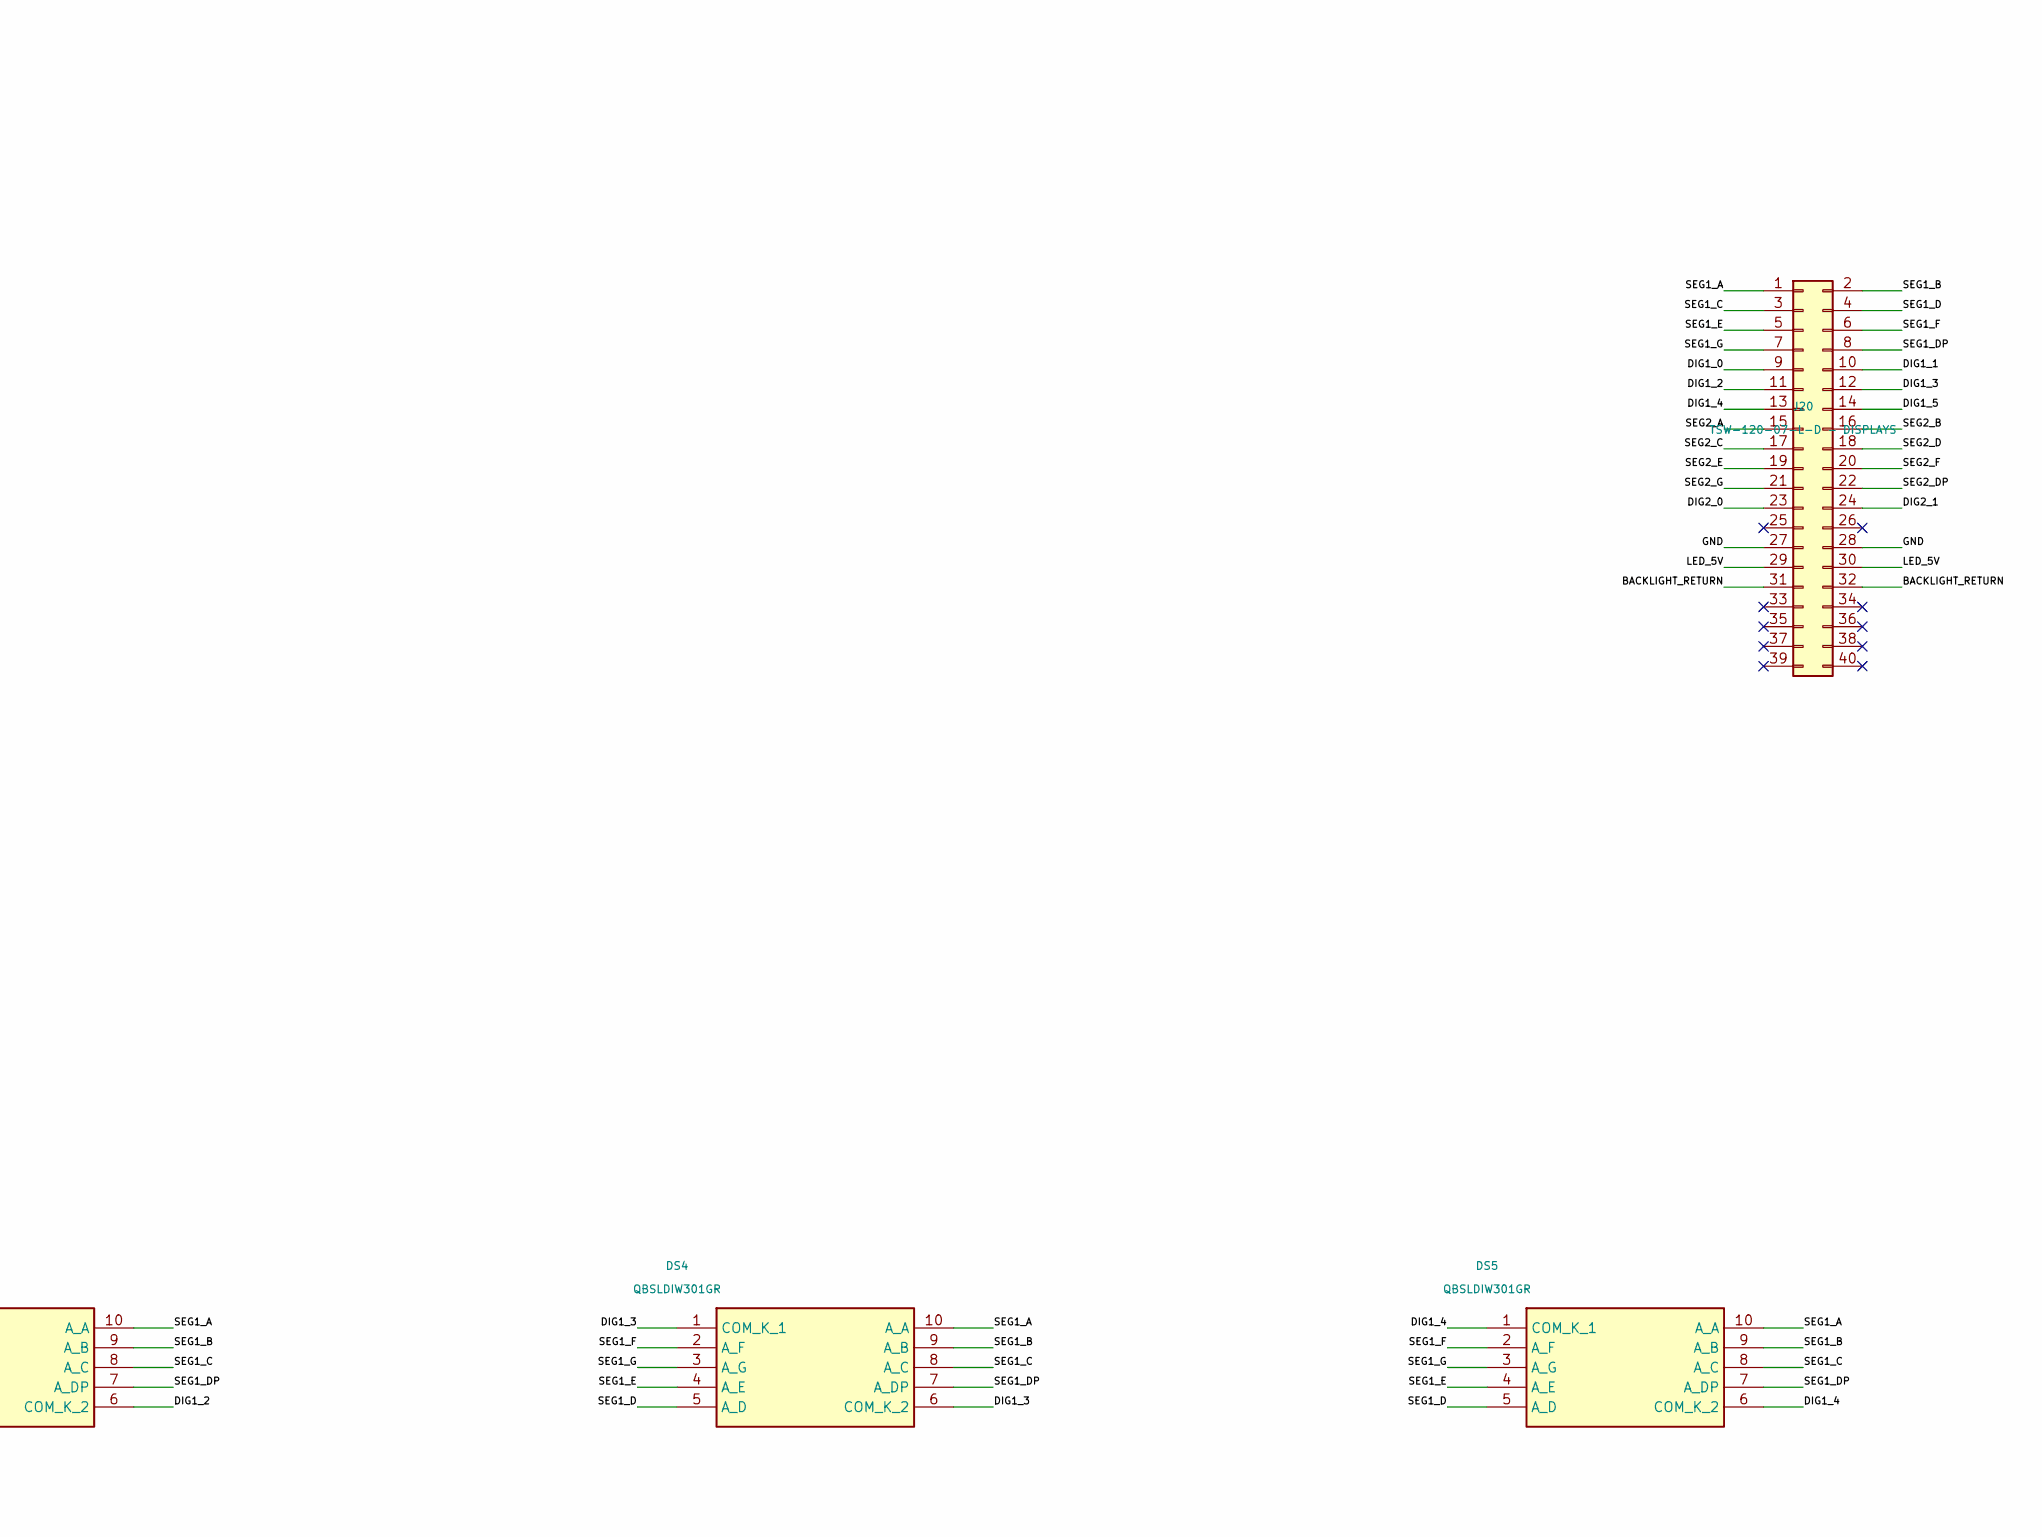
[picture p31: schematic LED Subboard.kicad_sch, ARC-164 LED Subboard v1.2 - physical fit tested; electrical…, part in row 1, column 2]

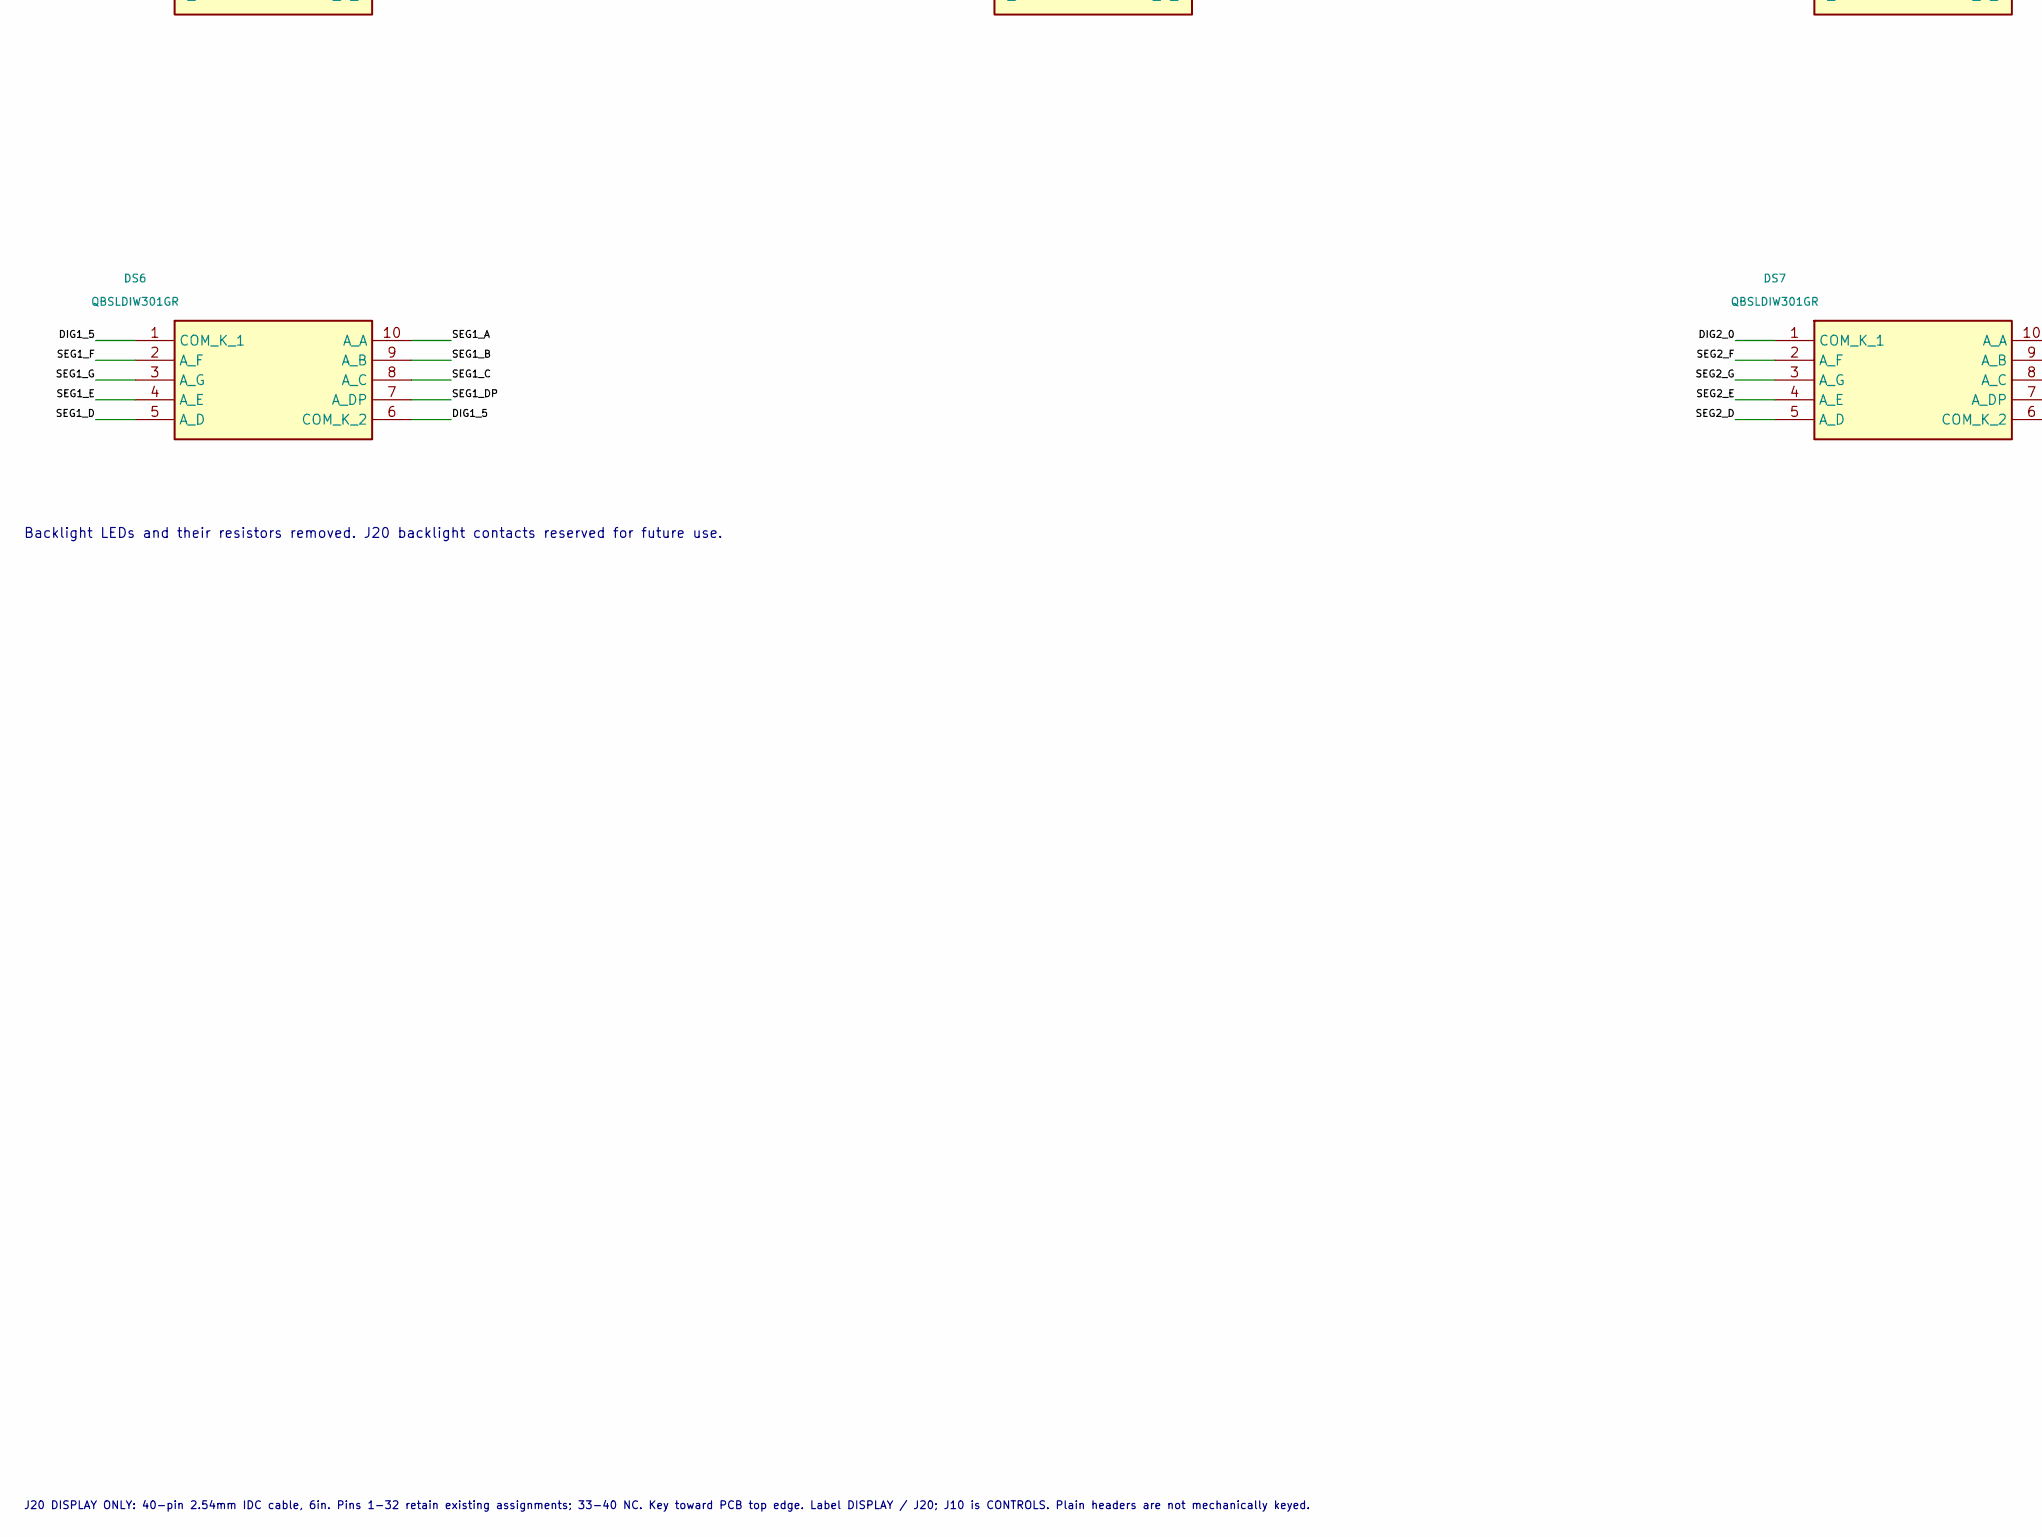
[picture p32: schematic LED Subboard.kicad_sch, ARC-164 LED Subboard v1.2 - physical fit tested; electrical…, part in row 2, column 1]

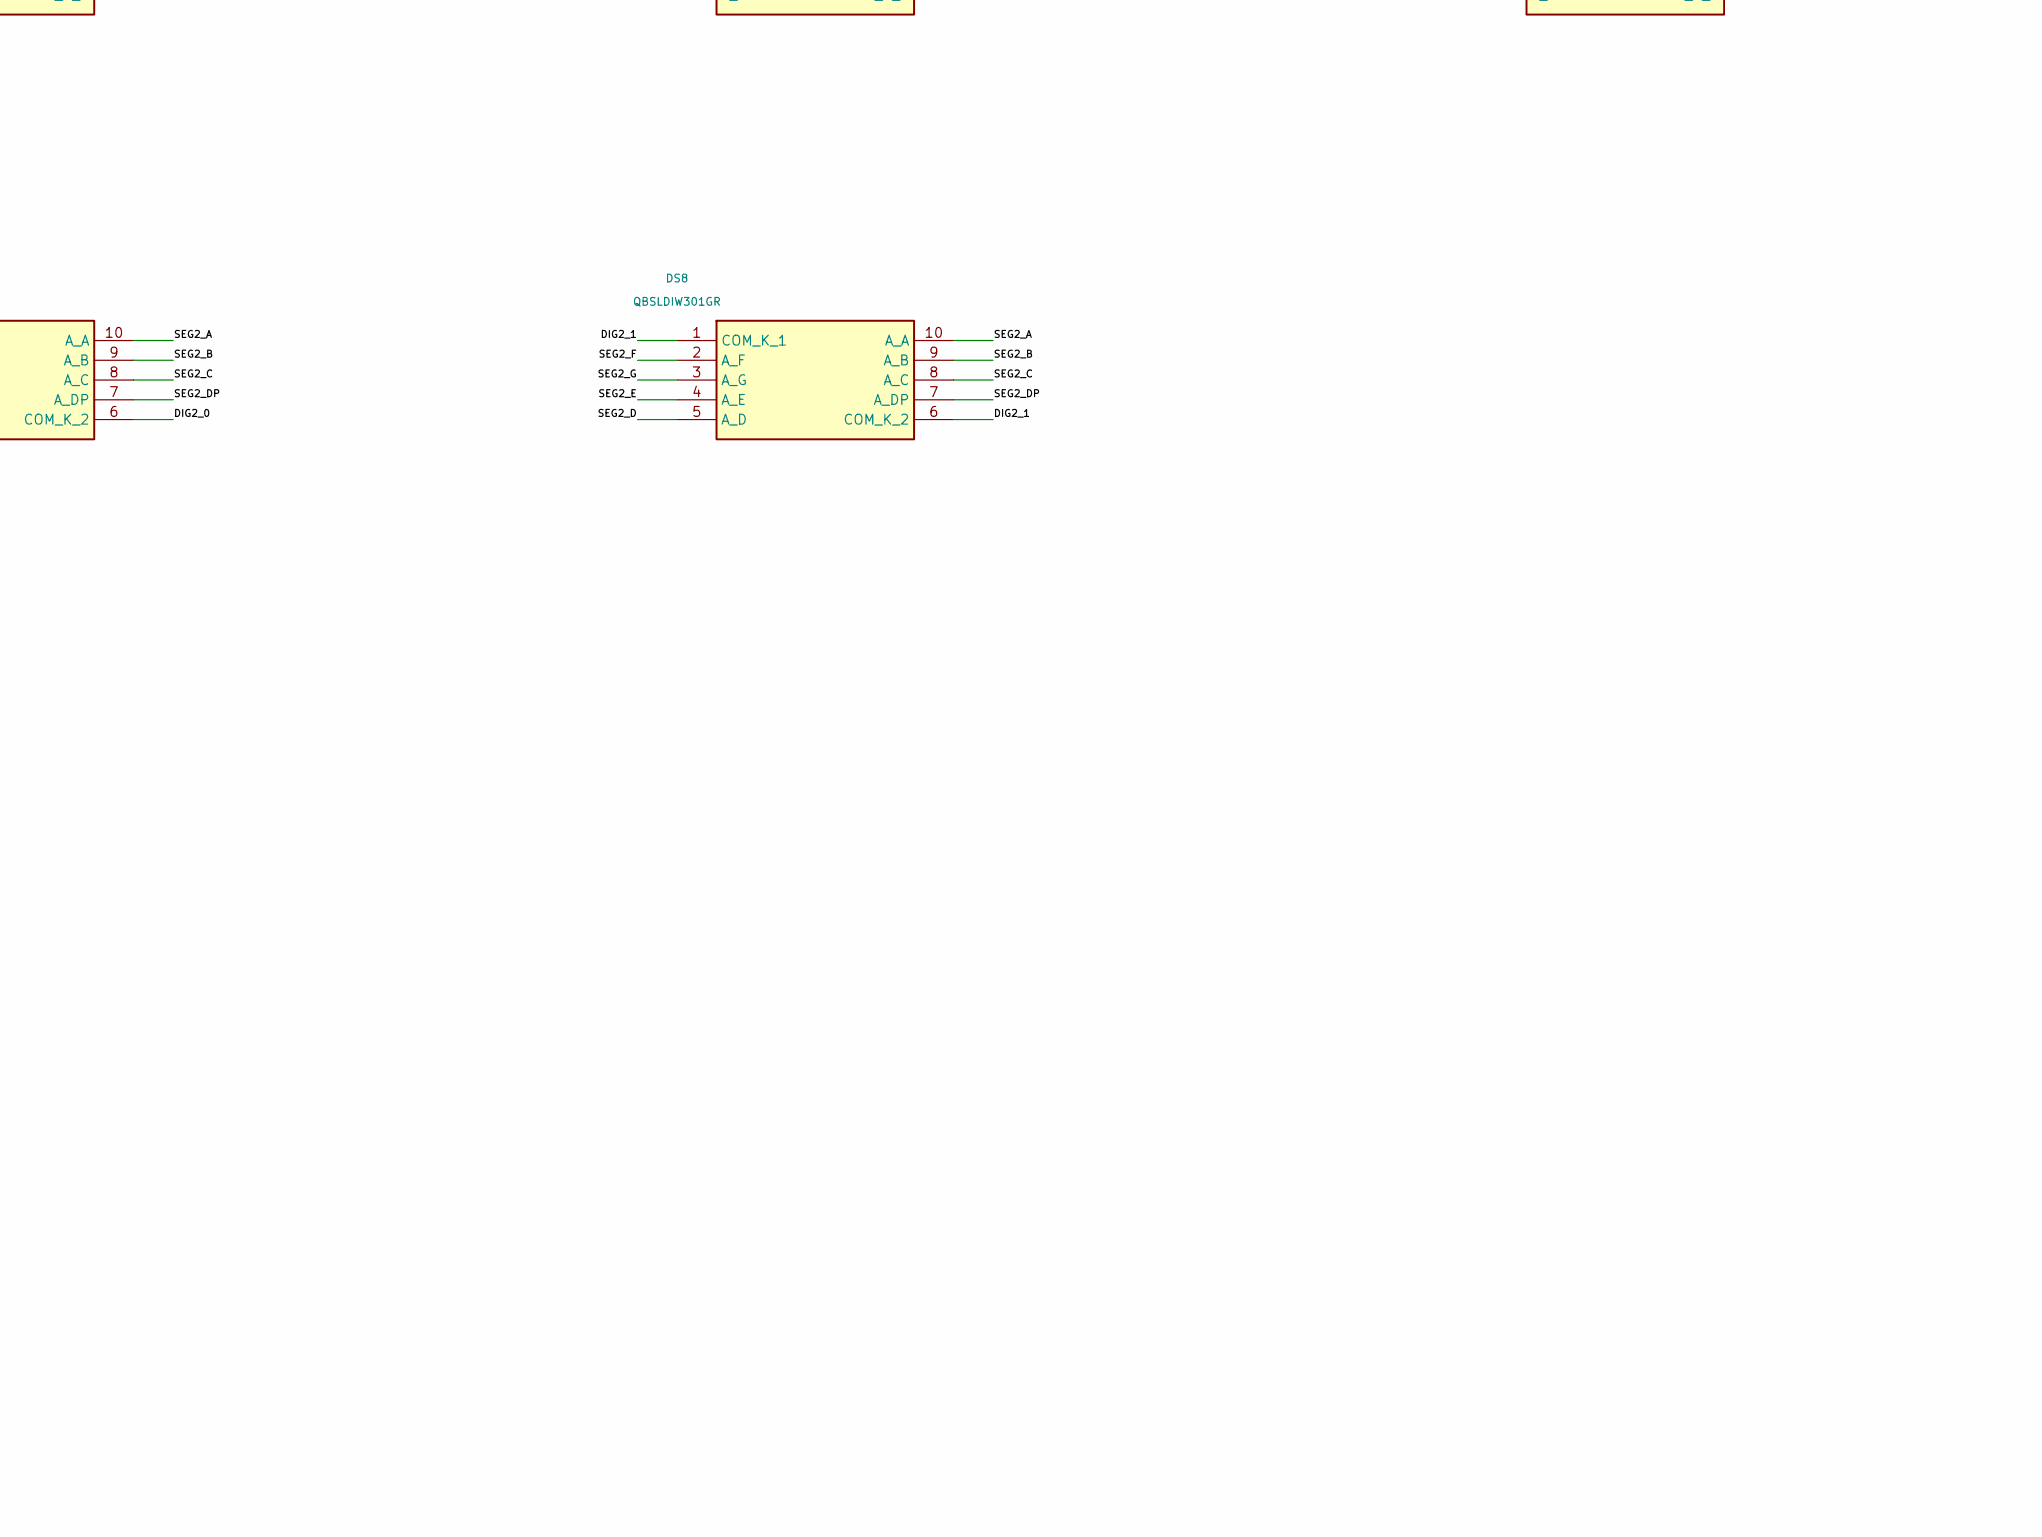
[picture p33: schematic LED Subboard.kicad_sch, ARC-164 LED Subboard v1.2 - physical fit tested; electrical…, part in row 2, column 2]

Parts:
DS1, DS2, DS3, DS4, DS5, DS6, DS7, DS8: QBSLDIW301GR
J20: TSW-120-07-L-D - DISPLAYS; PinHeader_2x20_P2.54mm_Vertical

Connections:
/BACKLIGHT_RETURN: J20.31, J20.32
/DIG1_0: DS1.1 (COM_K_1), DS1.6 (COM_K_2), J20.9
/DIG1_1: DS2.1 (COM_K_1), DS2.6 (COM_K_2), J20.10
/DIG1_2: DS3.1 (COM_K_1), DS3.6 (COM_K_2), J20.11
/DIG1_3: DS4.1 (COM_K_1), DS4.6 (COM_K_2), J20.12
/DIG1_4: DS5.1 (COM_K_1), DS5.6 (COM_K_2), J20.13
/DIG1_5: DS6.1 (COM_K_1), DS6.6 (COM_K_2), J20.14
/DIG2_0: DS7.1 (COM_K_1), DS7.6 (COM_K_2), J20.23
/DIG2_1: DS8.1 (COM_K_1), DS8.6 (COM_K_2), J20.24
/GND: J20.27, J20.28
/LED_5V: J20.29, J20.30
/SEG1_A: DS1.10 (A_A), DS2.10 (A_A), DS3.10 (A_A), DS4.10 (A_A), DS5.10 (A_A), DS6.10 (A_A), J20.1
/SEG1_B: DS1.9 (A_B), DS2.9 (A_B), DS3.9 (A_B), DS4.9 (A_B), DS5.9 (A_B), DS6.9 (A_B), J20.2
/SEG1_C: DS1.8 (A_C), DS2.8 (A_C), DS3.8 (A_C), DS4.8 (A_C), DS5.8 (A_C), DS6.8 (A_C), J20.3
/SEG1_D: DS1.5 (A_D), DS2.5 (A_D), DS3.5 (A_D), DS4.5 (A_D), DS5.5 (A_D), DS6.5 (A_D), J20.4
/SEG1_DP: DS1.7 (A_DP), DS2.7 (A_DP), DS3.7 (A_DP), DS4.7 (A_DP), DS5.7 (A_DP), DS6.7 (A_DP), J20.8
/SEG1_E: DS1.4 (A_E), DS2.4 (A_E), DS3.4 (A_E), DS4.4 (A_E), DS5.4 (A_E), DS6.4 (A_E), J20.5
/SEG1_F: DS1.2 (A_F), DS2.2 (A_F), DS3.2 (A_F), DS4.2 (A_F), DS5.2 (A_F), DS6.2 (A_F), J20.6
/SEG1_G: DS1.3 (A_G), DS2.3 (A_G), DS3.3 (A_G), DS4.3 (A_G), DS5.3 (A_G), DS6.3 (A_G), J20.7
/SEG2_A: DS7.10 (A_A), DS8.10 (A_A), J20.15
/SEG2_B: DS7.9 (A_B), DS8.9 (A_B), J20.16
/SEG2_C: DS7.8 (A_C), DS8.8 (A_C), J20.17
/SEG2_D: DS7.5 (A_D), DS8.5 (A_D), J20.18
/SEG2_DP: DS7.7 (A_DP), DS8.7 (A_DP), J20.22
/SEG2_E: DS7.4 (A_E), DS8.4 (A_E), J20.19
/SEG2_F: DS7.2 (A_F), DS8.2 (A_F), J20.20
/SEG2_G: DS7.3 (A_G), DS8.3 (A_G), J20.21

Notes on the sheet:
ARC-164 plug-in LED module: six frequency digits and two preset digits
Display drivers, buffering, Teensy and backlight MOSFET are on the Power Driver Board. J20 is a 40-pin display cable.
Channel encoder removed from module. J20 contacts 25 and 26 are reserved / not connected.
Backlight LEDs and their resistors removed. J20 backlight contacts reserved for future use.
J20 DISPLAY ONLY: 40-pin 2.54mm IDC cable, 6in. Pins 1-32 retain existing assignments; 33-40 NC. Key toward PCB top edge. Label DISPLAY / J20; J10 is CONTROLS. Plain headers are not mechanically keyed.

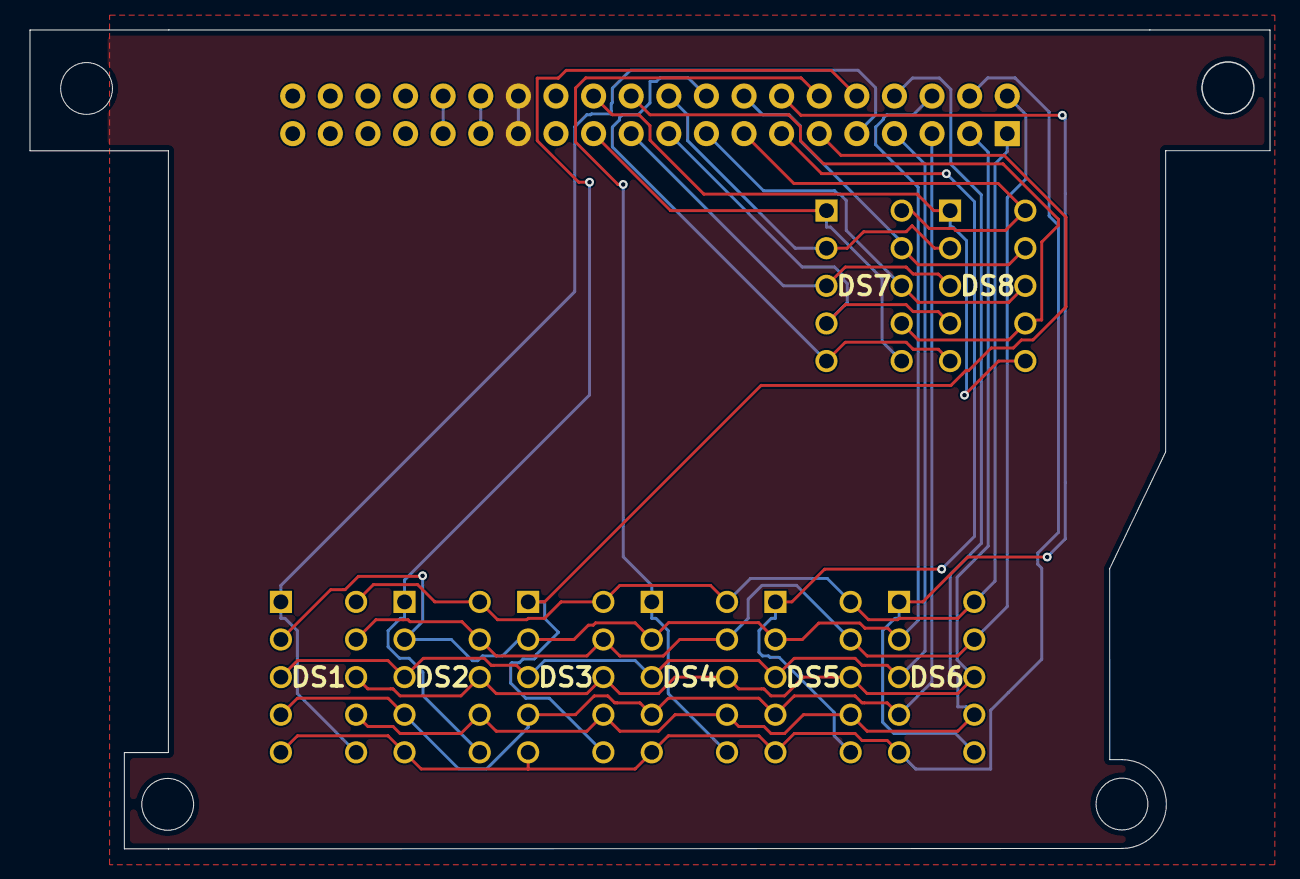
[picture p34: board LED Subboard.kicad_pcb from above]

Board: 2 copper layers, 83.8 x 55.3 mm, 9 parts (1 on the bottom side), 27 nets.
