dgdimick/ARC-164-DCS-Display/PCBs/v1.2/Main-Board/Project/Main Board.kicad_pcb

## KiCad design PCBs/v1.2/Main-Board/Project/Main Board.kicad_pcb (2026-11-10)

Schematic: Main Board.kicad_sch, ARC-164 Main Board - UNTESTED PROTOTYPE

Parts:
D1, D2, D3, D4, D5, D6, D7, D8, D9, D10, D11, D12, D13, D14, D15, D16, D17, D18, D19: WP710A10SGD; LED_D3.0mm_Green
J10: Controls cable to Power Driver Board J10; PinHeader_2x20_P2.54mm_Vertical
J21: Backlight power from driver J21; PinHeader_1x03_P2.54mm_Vertical
J22: Auxiliary resistor-limited backlight output; WireSolderPads_1x02_P4.6mm_D1.7mm_18AWG
R1, R2, R3, R4, R5, R6, R7, R8, R9, R10, R11, R12, R13, R14, R15, R16, R17, R18, R19: 330; R_Axial_DIN0207_L6.3mm_D2.5mm_P10.16mm_Horizontal
SW1, SW2, SW3, SW4, SW5, SW6, SW9: PEC11R-4230F-S0024; PEC11R4230FS0024
SW7, SW8: A12505RNCQ
SW10: TONE - wire solder pads; WireSolderPads_1x02_P4.6mm_D1.7mm_18AWG
SW11: SQL - wire solder pads; WireSolderPads_1x02_P4.6mm_D1.7mm_18AWG
SW12: LOAD (magnetic reed) - wire solder pads; WireSolderPads_1x02_P4.6mm_D1.7mm_18AWG
SW13: TEST_DISPLAY - wire solder pads; WireSolderPads_1x02_P4.6mm_D1.7mm_18AWG
SW14: STATUS - wire solder pads; WireSolderPads_1x02_P4.6mm_D1.7mm_18AWG

Connections:
/BACKLIGHT_RETURN: D1.1 (K), D2.1 (K), D3.1 (K), D4.1 (K), D5.1 (K), D6.1 (K), D7.1 (K), D8.1 (K), D9.1 (K), D10.1 (K), D11.1 (K), D12.1 (K), D13.1 (K), D14.1 (K), D15.1 (K), D16.1 (K), D17.1 (K), D18.1 (K), D19.1 (K), J21.2, J22.2
/BL_ANODE_01: D1.2 (A), R1.2
/BL_ANODE_02: D2.2 (A), R2.2
/BL_ANODE_03: D3.2 (A), R3.2
/BL_ANODE_05: D4.2 (A), R4.2
/BL_ANODE_06: D5.2 (A), R5.2
/BL_ANODE_07: D6.2 (A), R6.2
/BL_ANODE_09: D7.2 (A), R7.2
/BL_ANODE_10: D8.2 (A), R8.2
/BL_ANODE_11: D9.2 (A), R9.2
/BL_ANODE_13: D10.2 (A), R10.2
/BL_ANODE_14: D11.2 (A), R11.2
/BL_ANODE_15: D12.2 (A), R12.2
/BL_ANODE_17: D13.2 (A), R13.2
/BL_ANODE_18: D14.2 (A), R14.2
/BL_ANODE_19: D15.2 (A), R15.2
/BL_ANODE_21: D16.2 (A), R16.2
/BL_ANODE_22: D17.2 (A), R17.2
/BL_ANODE_23: D18.2 (A), R18.2
/BL_ANODE_25: D19.2 (A), R19.2
/CHANNEL_A: J10.16, SW6.A
/CHANNEL_B: J10.17, SW6.B
/FREQ1_A: J10.6, SW1.A
/FREQ1_B: J10.7, SW1.B
/FREQ2_A: J10.8, SW2.A
/FREQ2_B: J10.9, SW2.B
/FREQ3_A: J10.10, SW3.A
/FREQ3_B: J10.11, SW3.B
/FREQ4_A: J10.12, SW4.A
/FREQ4_B: J10.13, SW4.B
/FREQ5_A: J10.14, SW5.A
/FREQ5_B: J10.15, SW5.B
/GND: J10.1, J10.32, J21.3, SW1.C, SW1.MH1 (CASE), SW1.MH2 (CASE), SW2.C, SW2.MH1 (CASE), SW2.MH2 (CASE), SW3.C, SW3.MH1 (CASE), SW3.MH2 (CASE), SW4.C, SW4.MH1 (CASE), SW4.MH2 (CASE), SW5.C, SW5.MH1 (CASE), SW5.MH2 (CASE), SW6.C, SW6.MH1 (CASE), SW6.MH2 (CASE), SW7.A1 (COM), SW8.A1 (COM), SW9.C, SW9.MH1 (CASE), SW9.MH2 (CASE), SW10.2 (B), SW11.2 (B), SW12.2, SW13.2, SW14.2
/LED_5V: J21.1, J22.1, R1.1, R2.1, R3.1, R4.1, R5.1, R6.1, R7.1, R8.1, R9.1, R10.1, R11.1, R12.1, R13.1, R14.1, R15.1, R16.1, R17.1, R18.1, R19.1
/LOAD: J10.29, SW12.1
/MAIN_POS1: J10.20, SW7.1
/MAIN_POS2: J10.21, SW7.2
/MAIN_POS3: J10.22, SW7.4 (3)
/MAIN_POS4: J10.23, SW7.5 (4)
/PRESET_POS1: J10.24, SW8.1
/PRESET_POS2: J10.25, SW8.2
/PRESET_POS3: J10.26, SW8.4 (3)
/SQL: J10.28, SW11.1 (A)
/STATUS: J10.31, SW14.1
/TEST_DISPLAY: J10.30, SW13.1
/TONE: J10.27, SW10.1 (A)
/VOL_A: J10.18, SW9.A
/VOL_B: J10.19, SW9.B

Notes on the sheet:
ARC-164 Main Board: panel controls and backlight LEDs
J10 control cable mates pin-for-pin to driver J10. Pins 2-5 and 33-40 reserved NC. Inputs use Teensy 3.3V pull-ups.
J21: 1 regulated LED 5V; 2 MOSFET-switched LED return; 3 common ground. Never connect return pin 2 directly to GND.
19 green backlight LEDs are panel-facing on Main Board. Each has an individual 330 ohm series resistor; test physical fit and brightness.
19 provisional green backlight LEDs, each with 330 ohm series resistor. Driver PCB supplies DCS-BIOS PWM dimming.
BACKLIGHT: 19 provisional green LED branches. Position under lettering; count may change.
Each branch: LED_5V -> 330 ohm resistor -> LED anode; cathode -> BACKLIGHT_RETURN (PWM switched, not GND).

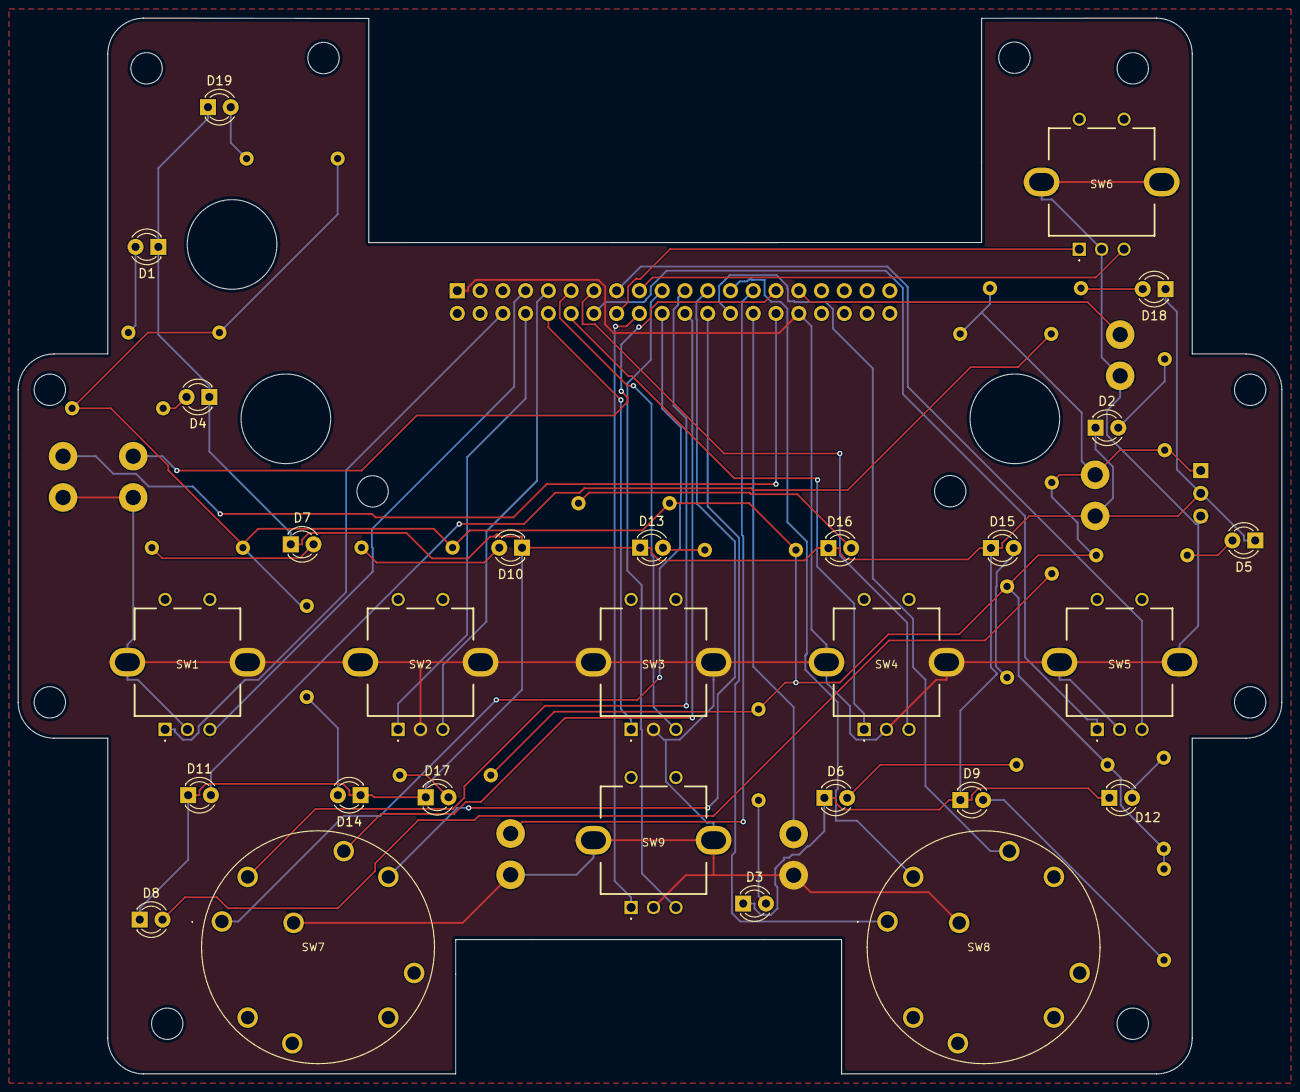
[picture p35: board Main Board.kicad_pcb from above]

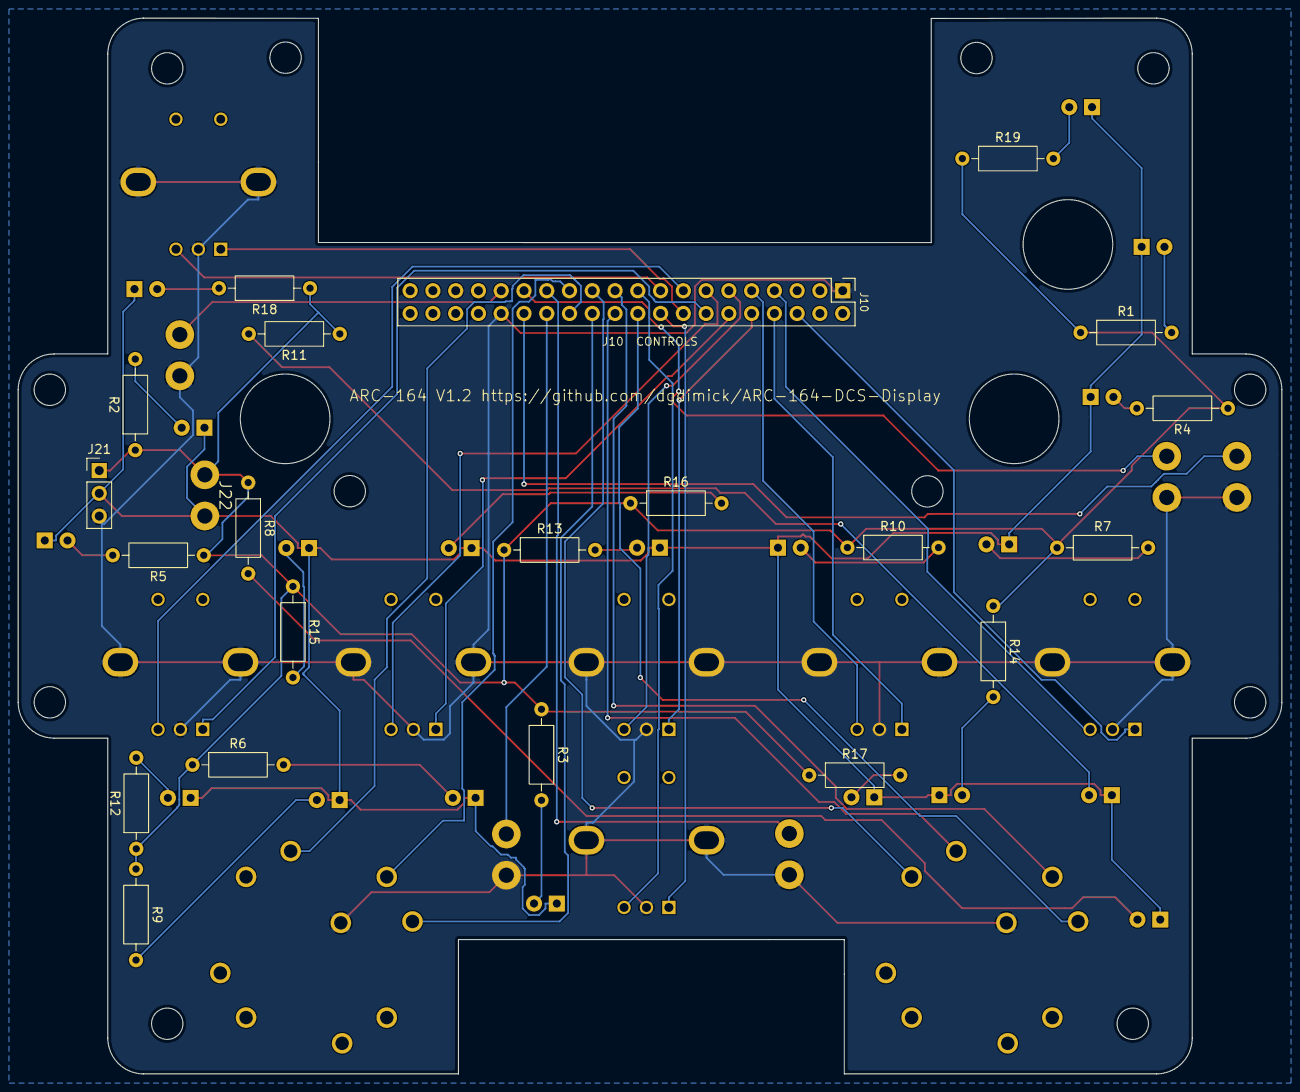
[picture p36: board Main Board.kicad_pcb from below]

Board: 2 copper layers, 141.0 x 117.8 mm, 55 parts (27 on the bottom side), 48 nets.
