dgdimick/ARC-164-DCS-Display/PCBs/v1.0-Prototype/Power-Driver-Board/Project/Power Driver Board.kicad_pcb

## KiCad design PCBs/v1.0-Prototype/Power-Driver-Board/Project/Power Driver Board.kicad_pcb (2026-11-07)

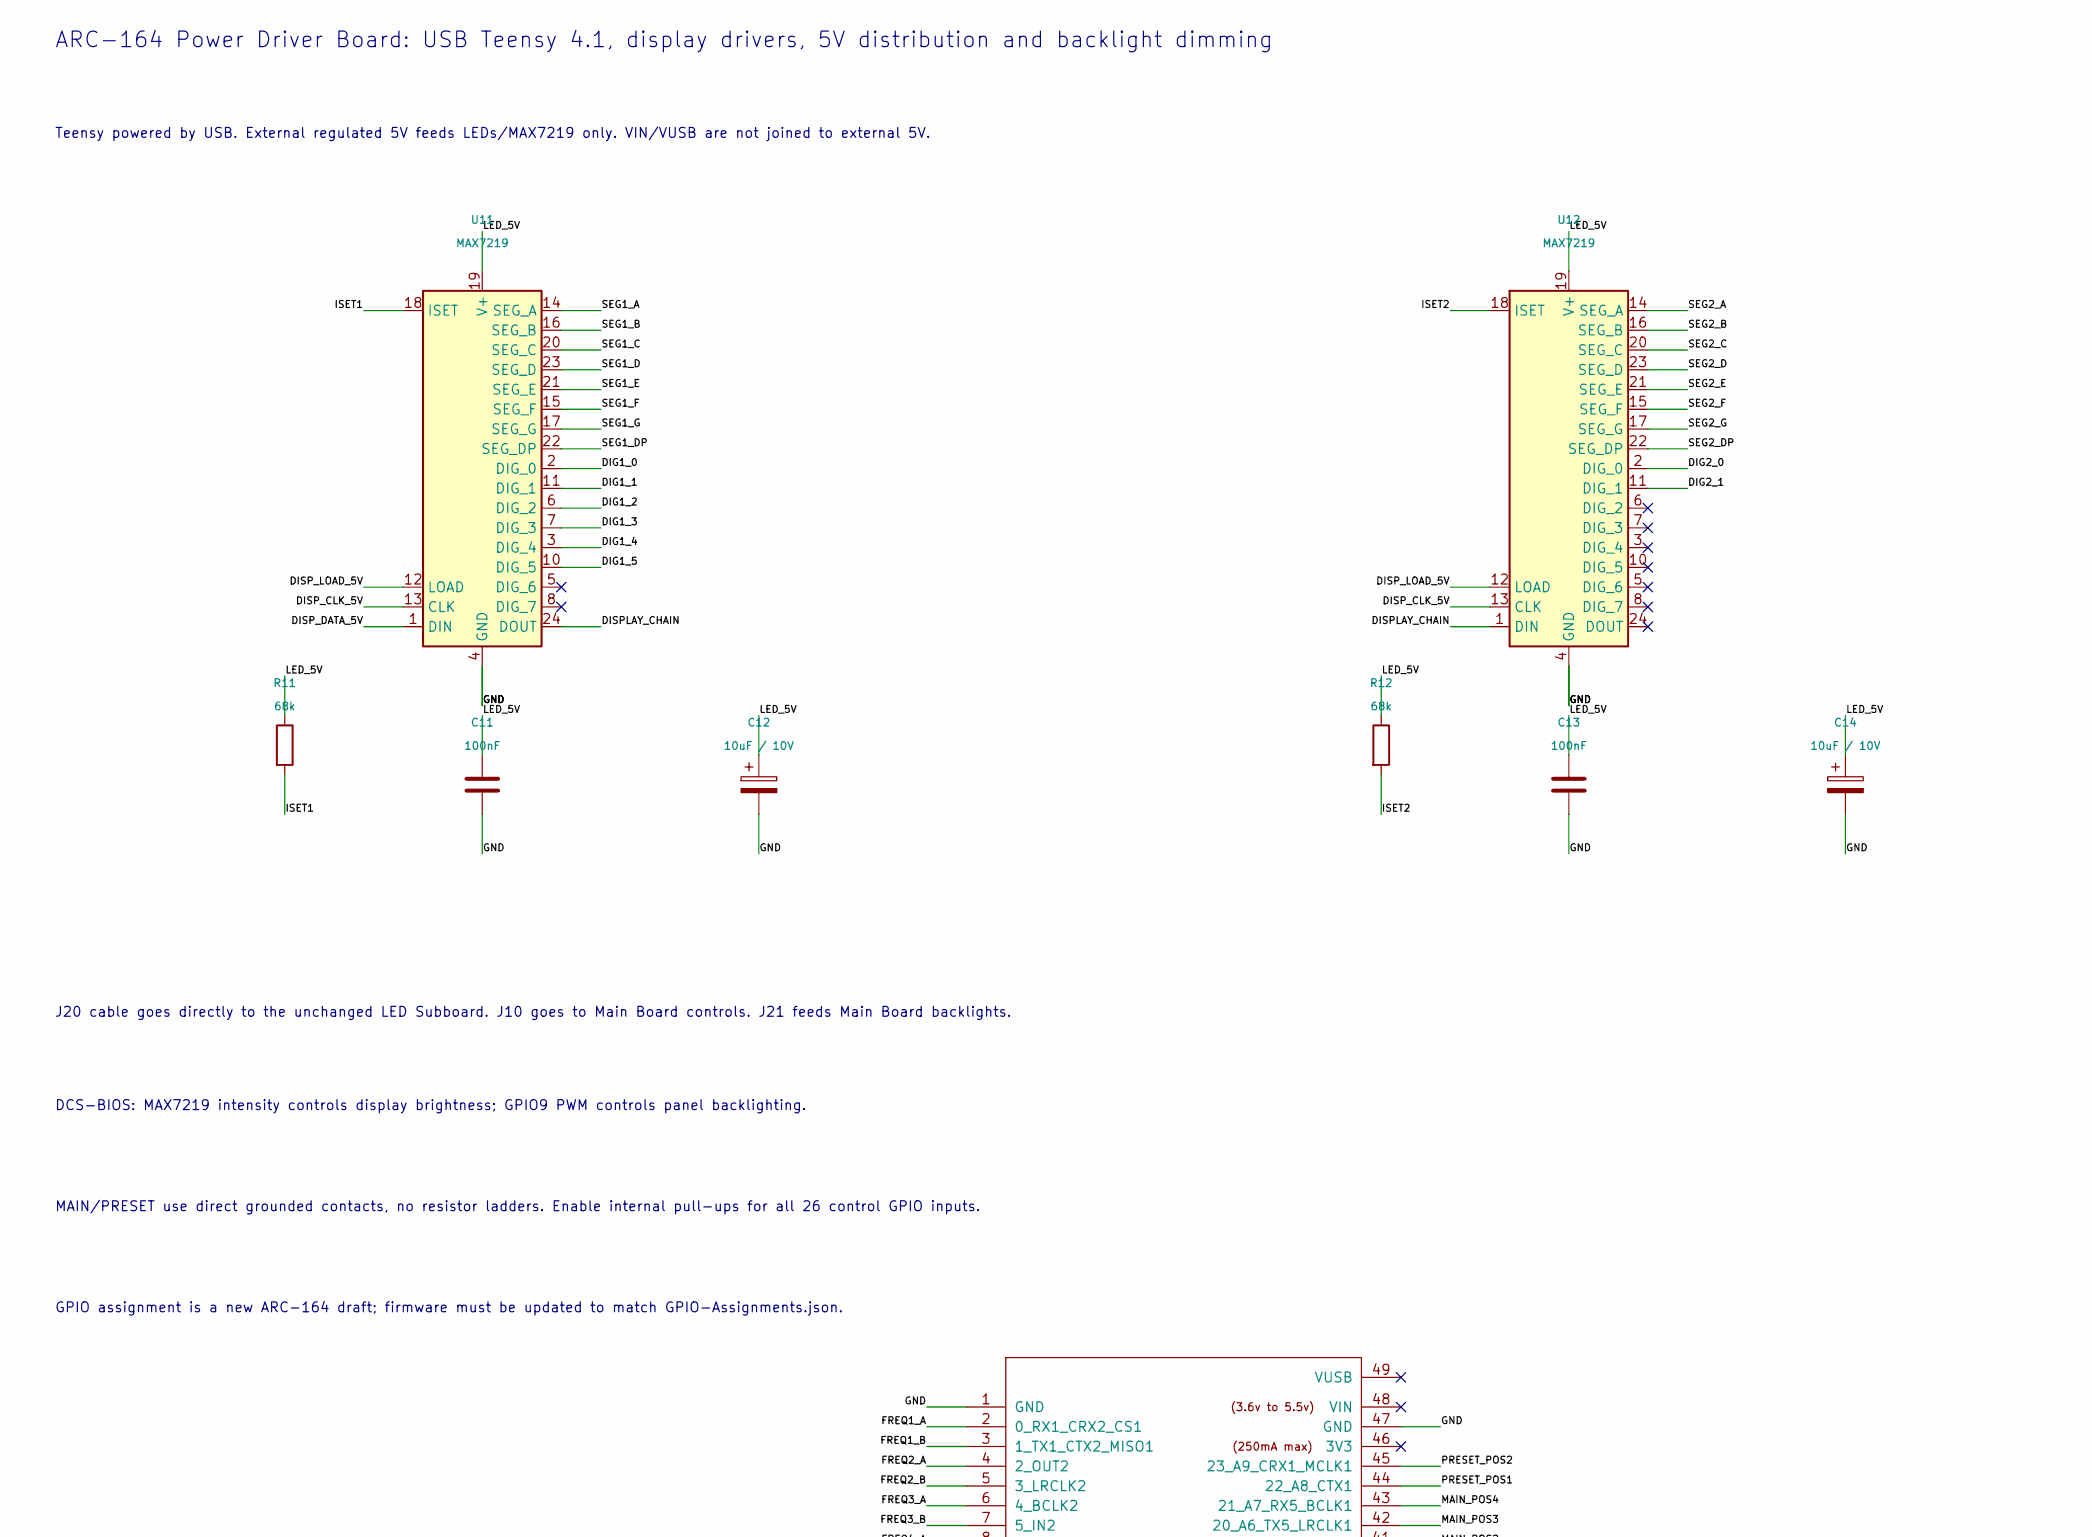
[picture p37: schematic Power Driver Board.kicad_sch, ARC-164 Power Driver Board - UNTESTED PROTOTYPE, part in row 1, column 1]

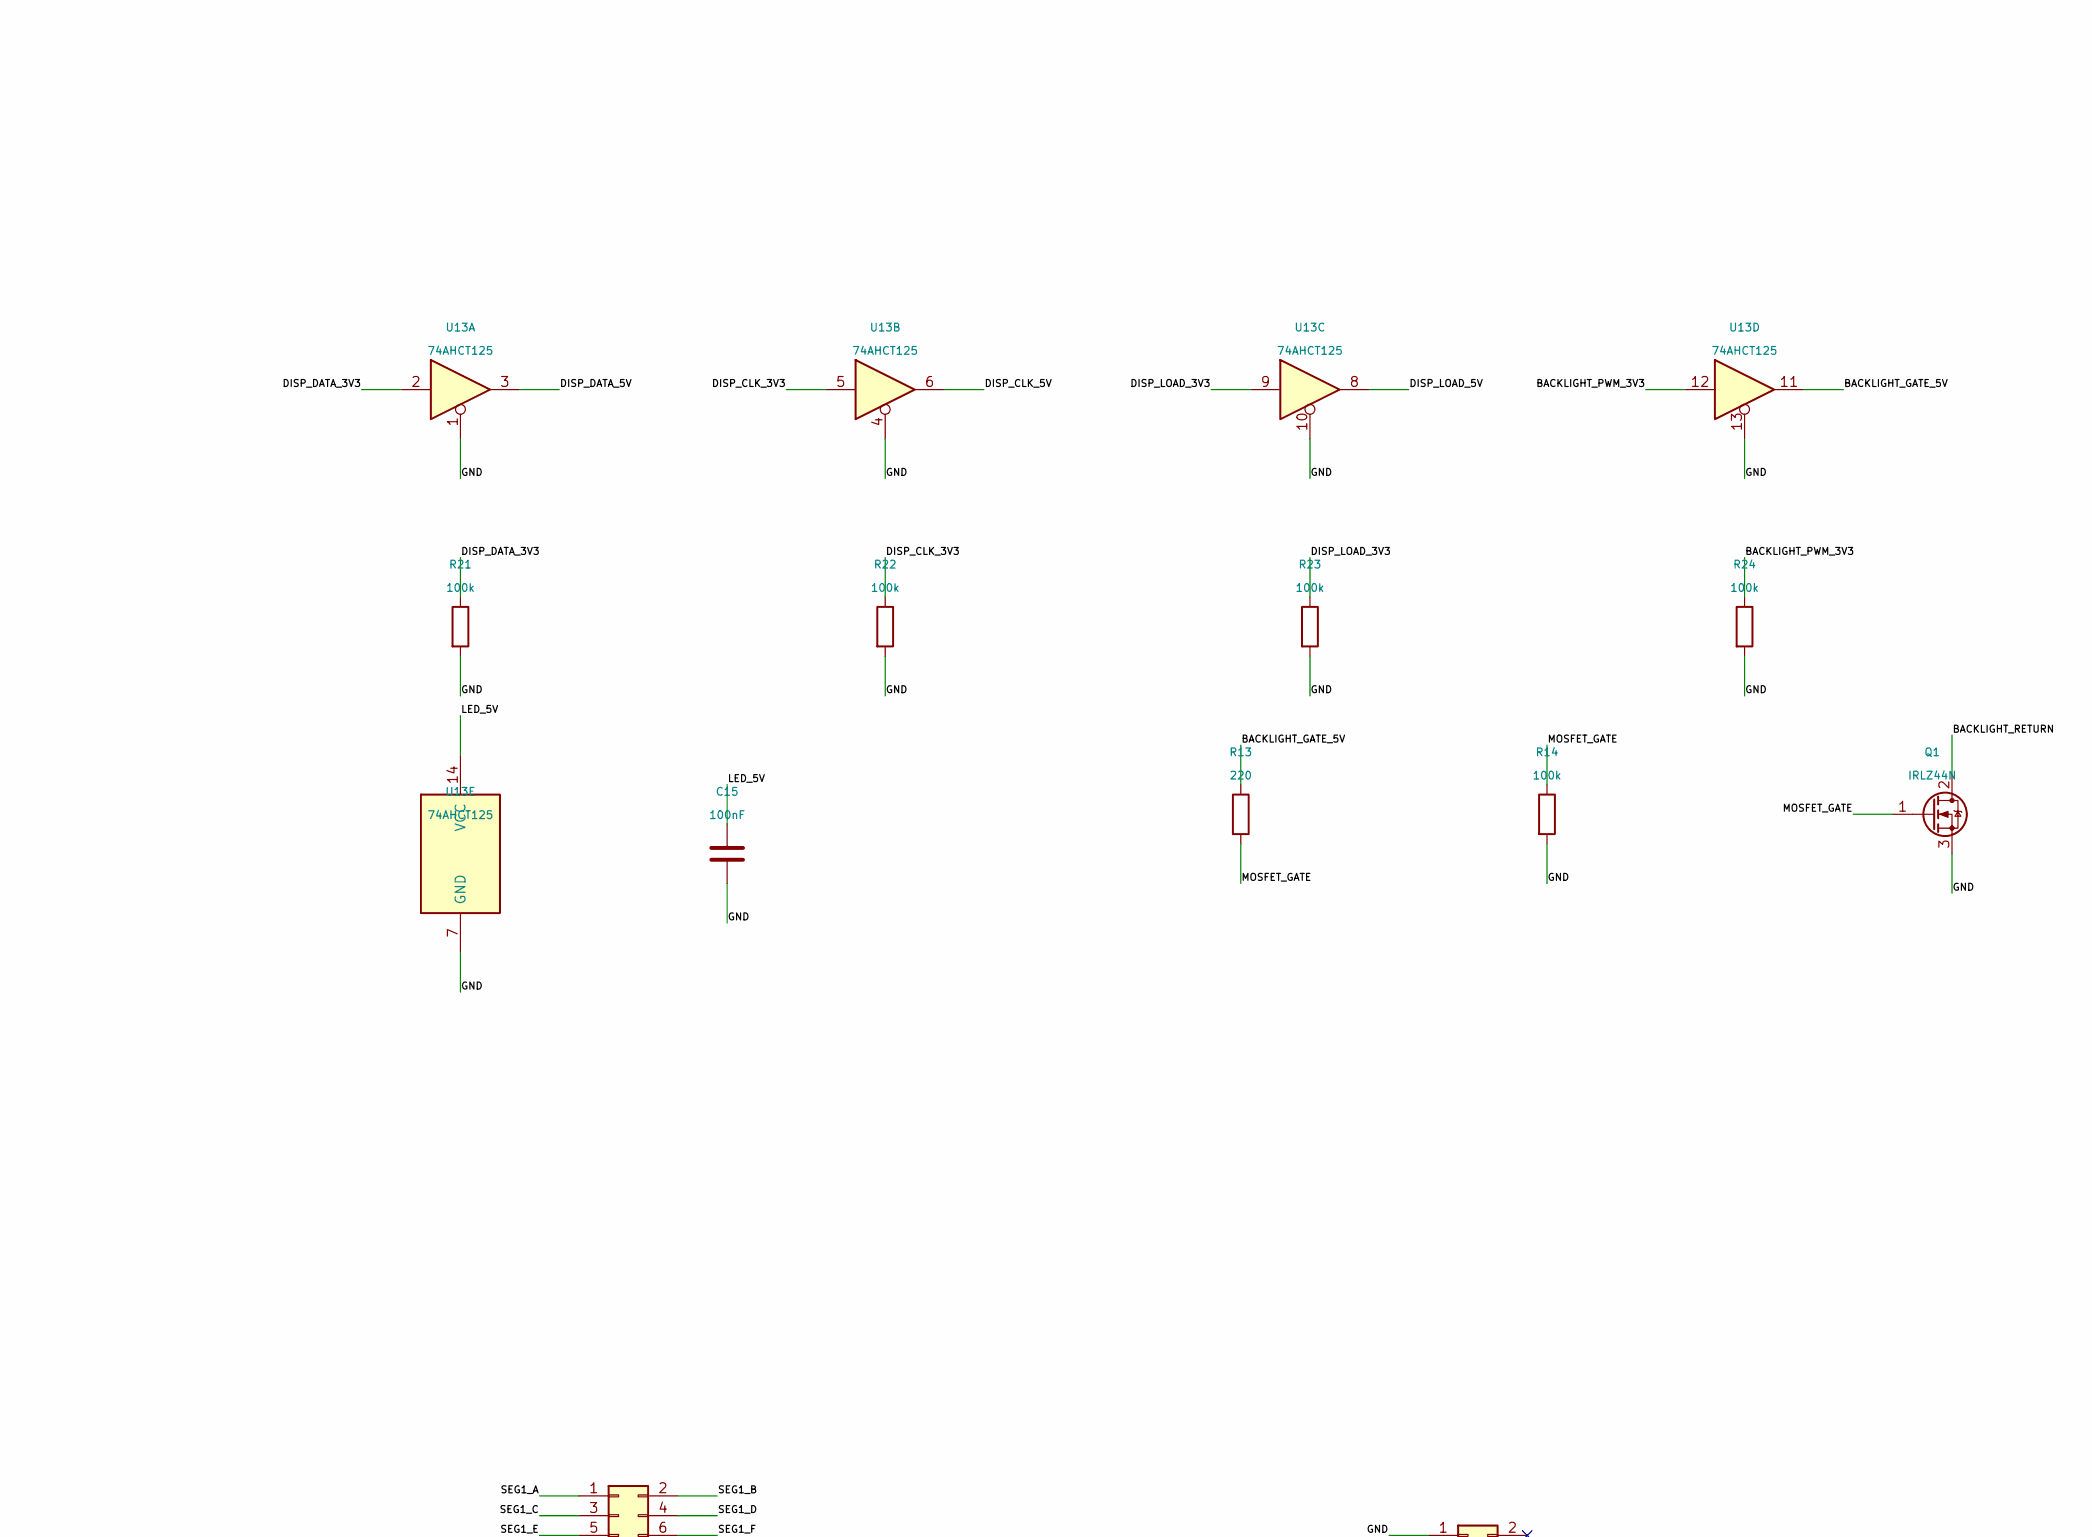
[picture p38: schematic Power Driver Board.kicad_sch, ARC-164 Power Driver Board - UNTESTED PROTOTYPE, part in row 1, column 2]

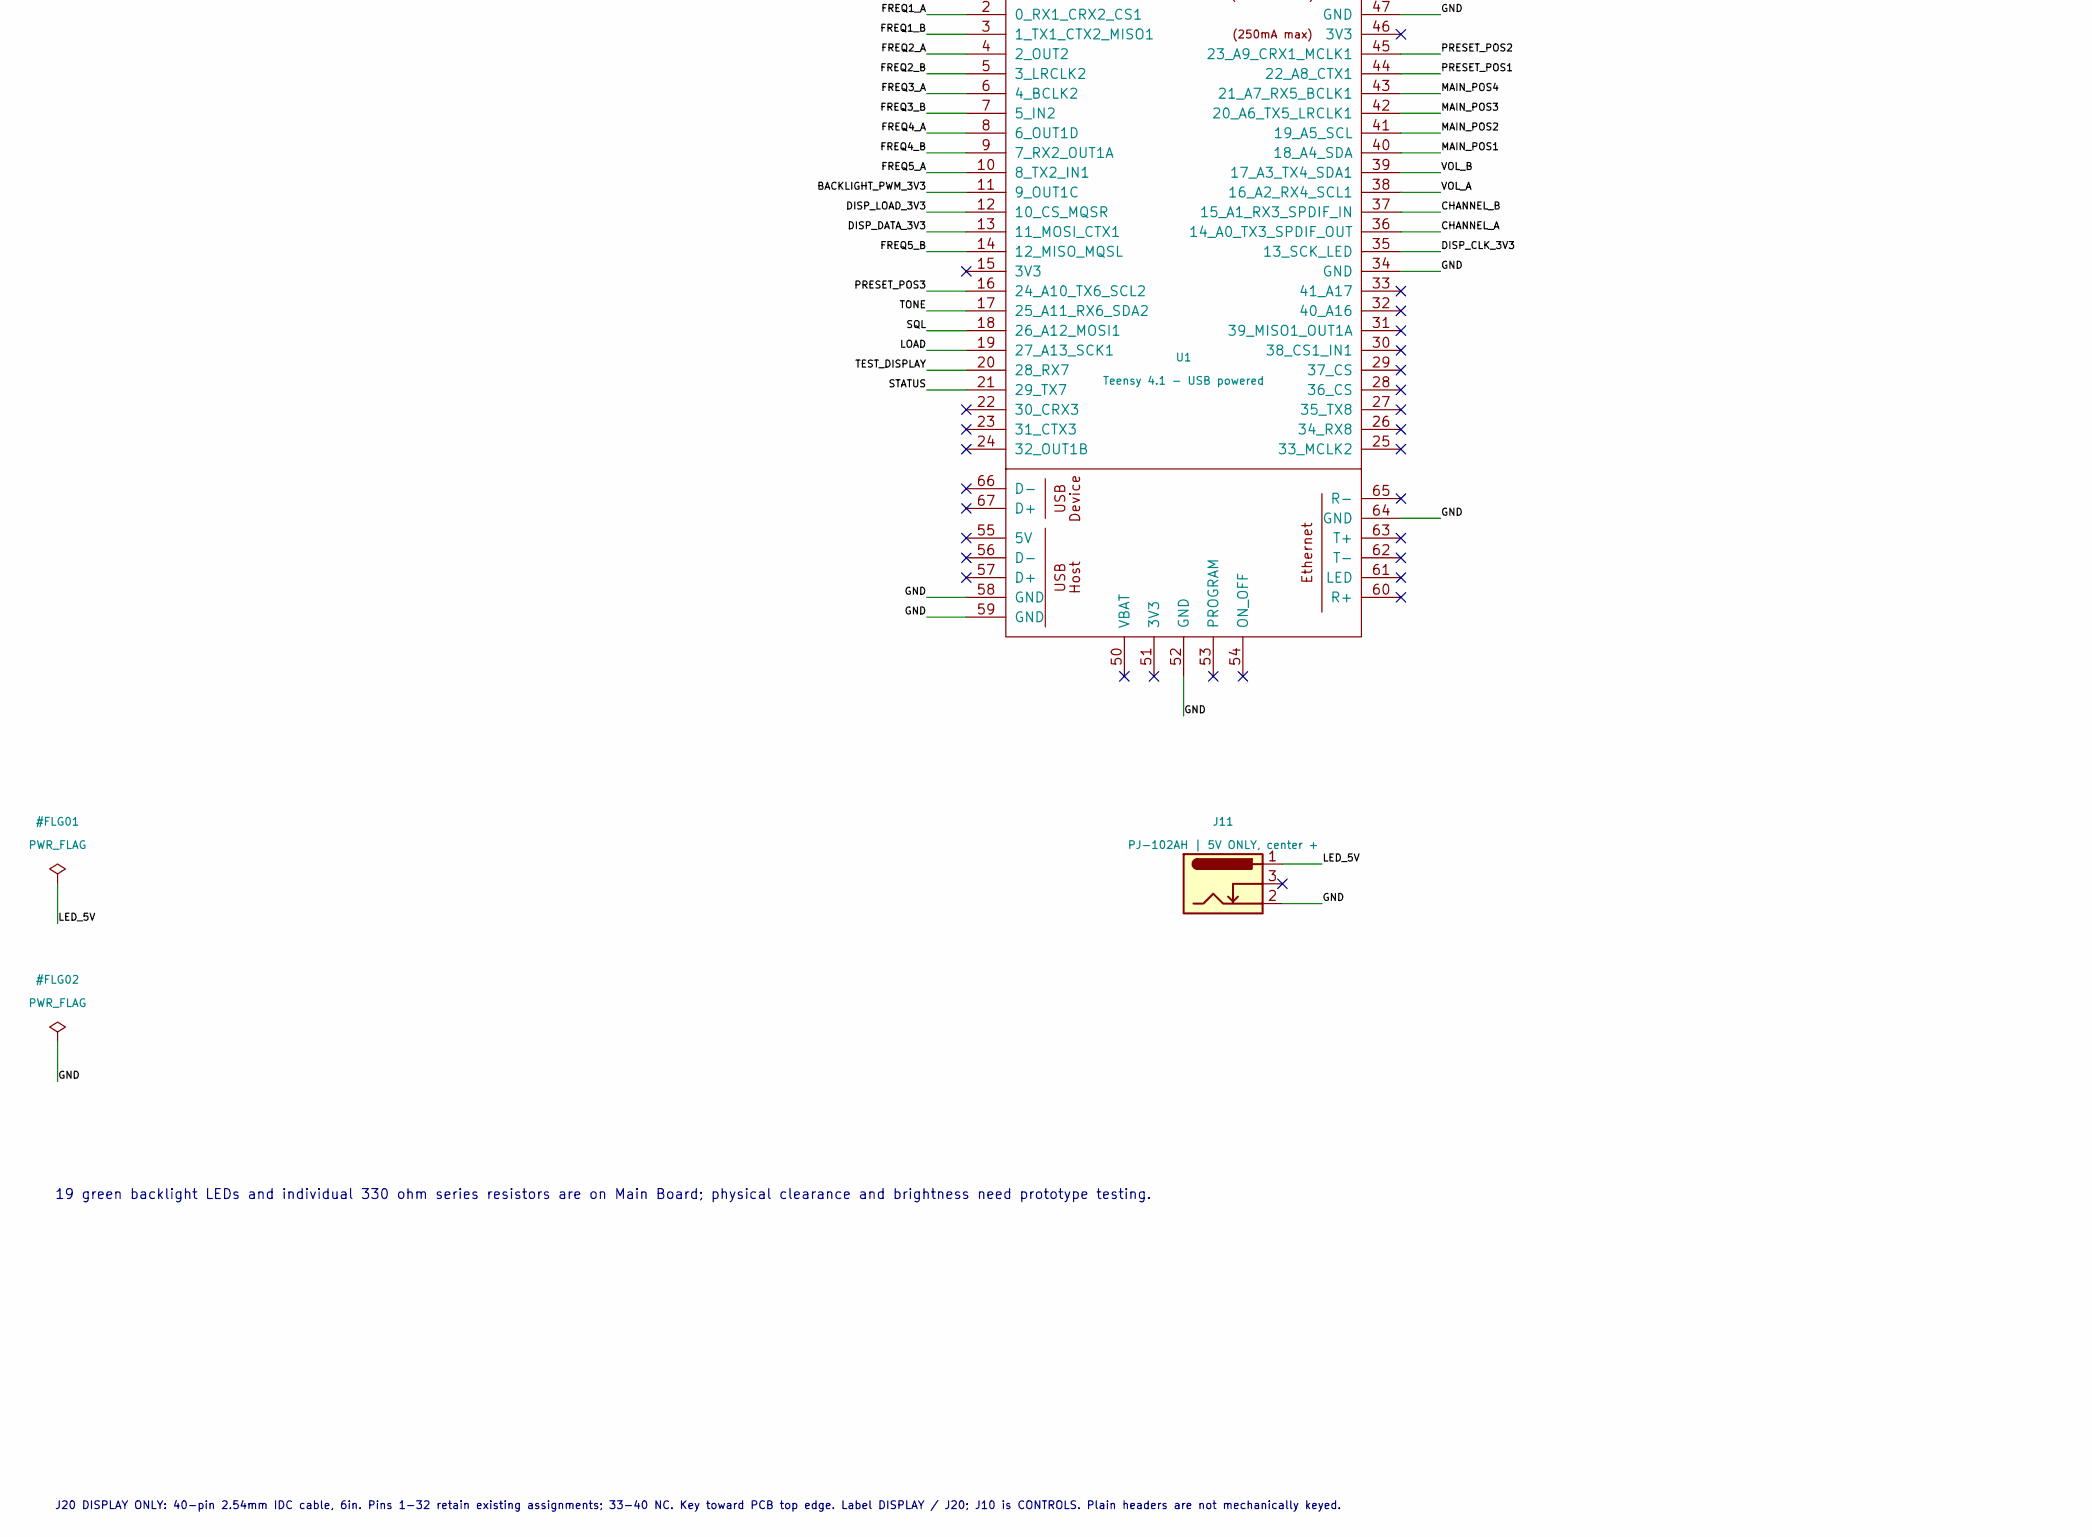
[picture p39: schematic Power Driver Board.kicad_sch, ARC-164 Power Driver Board - UNTESTED PROTOTYPE, part in row 2, column 1]

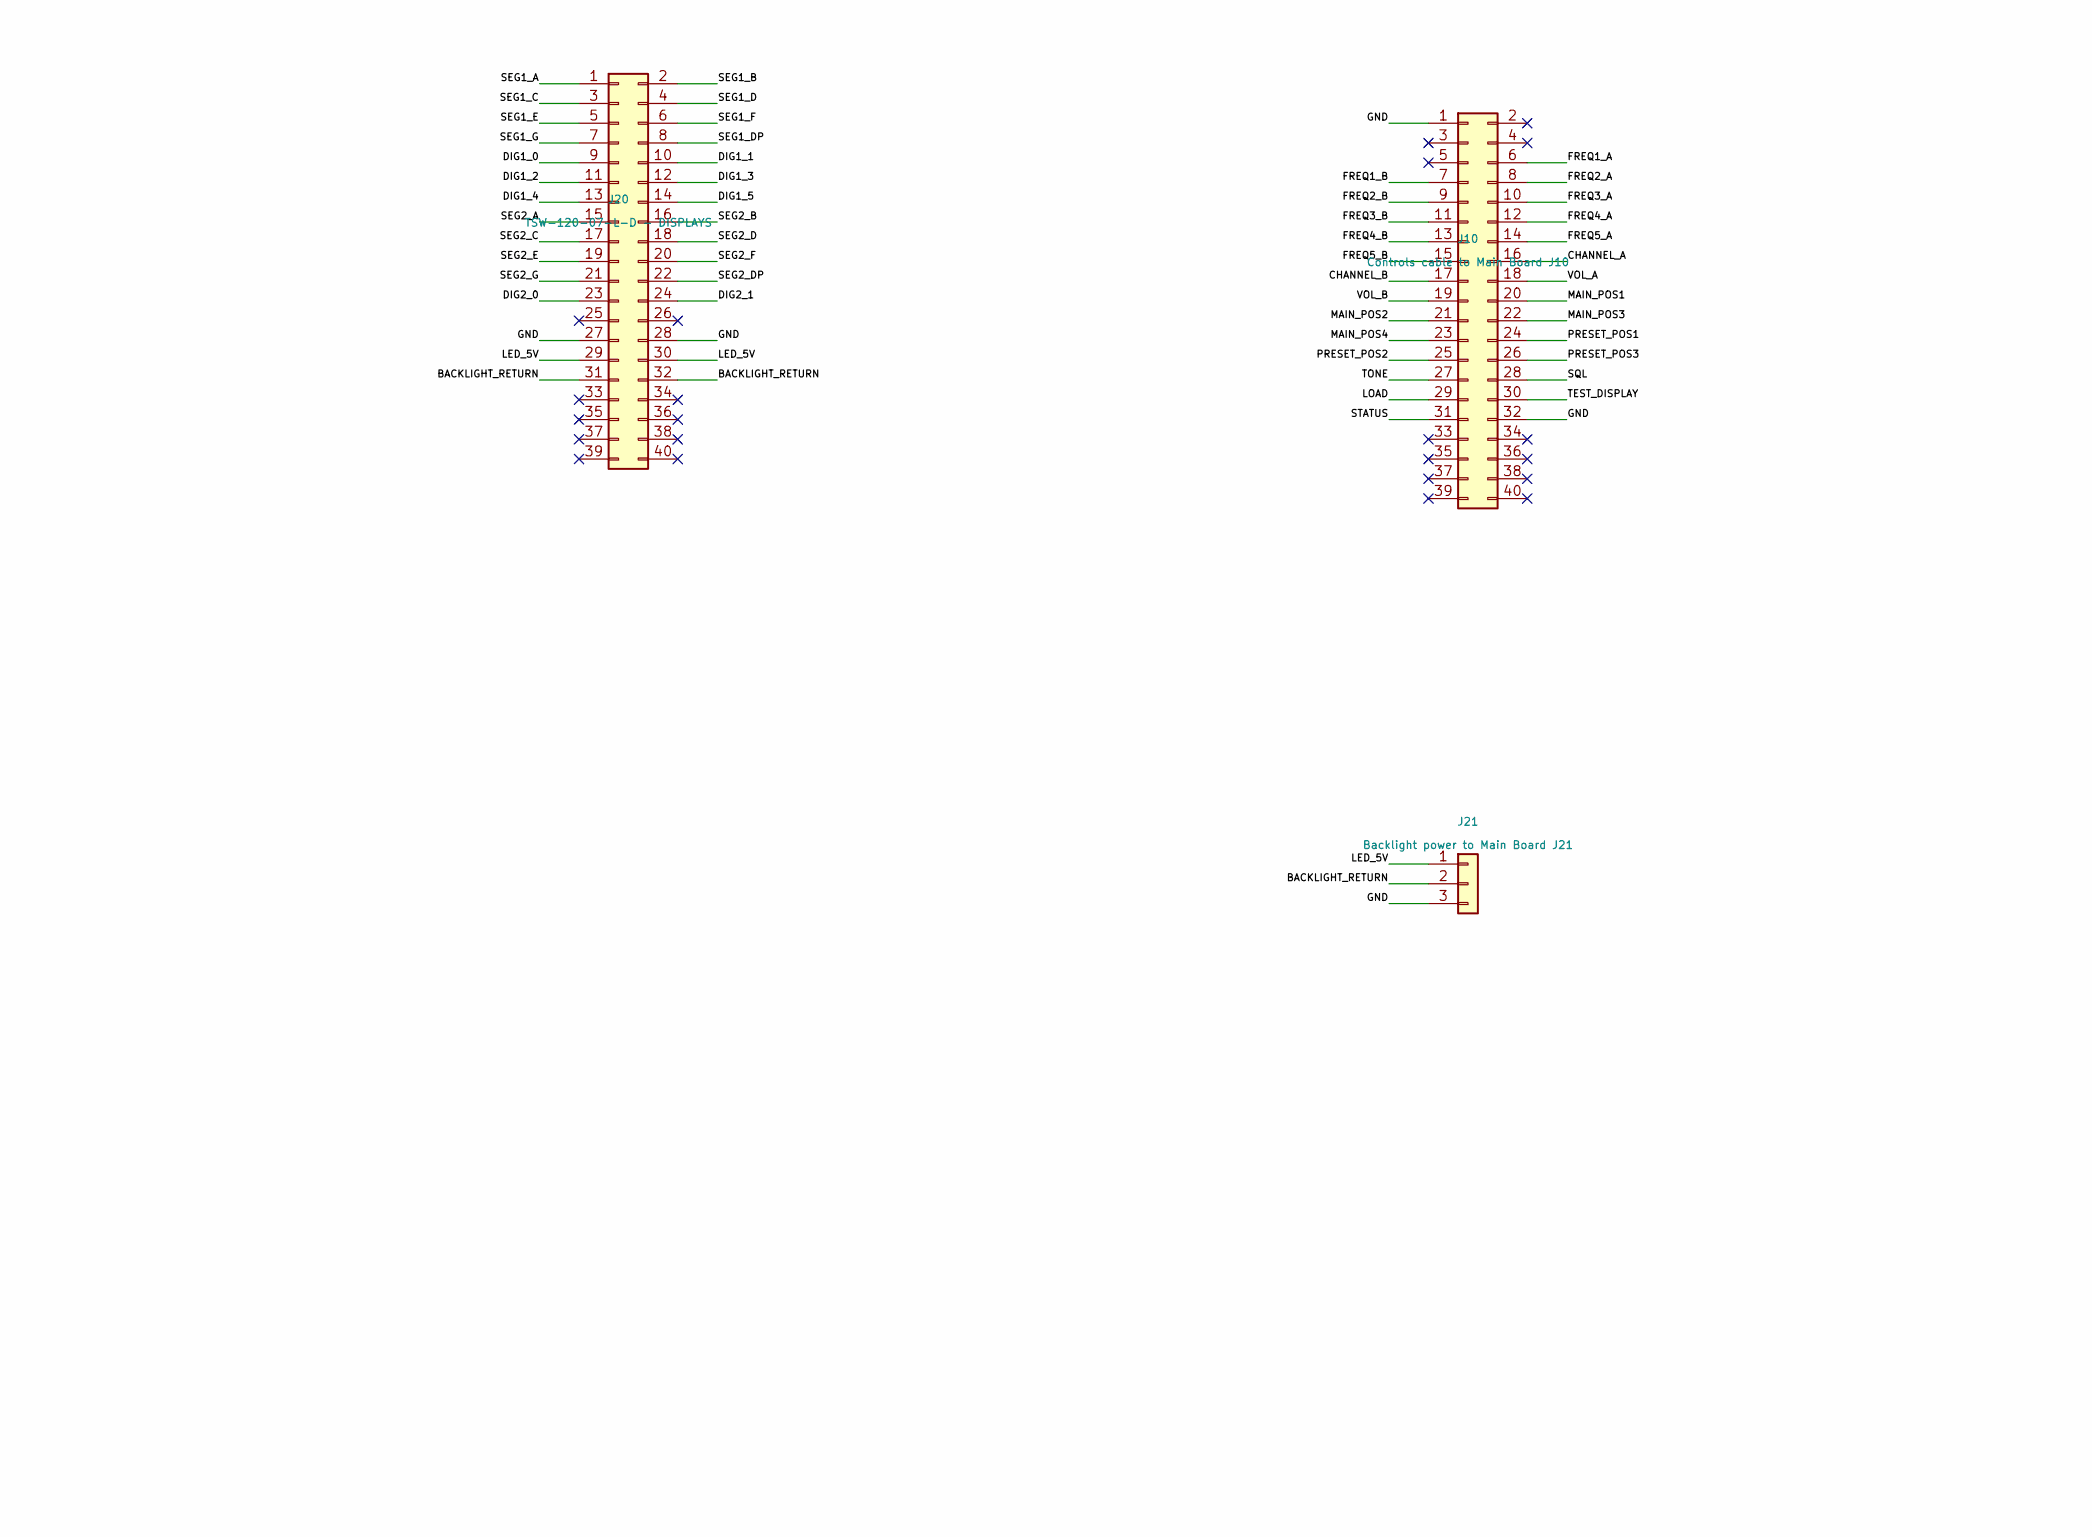
[picture p40: schematic Power Driver Board.kicad_sch, ARC-164 Power Driver Board - UNTESTED PROTOTYPE, part in row 2, column 2]

Parts:
C11, C13, C15: 100nF; C_Disc_D5.0mm_W2.5mm_P5.00mm
C12, C14: 10uF / 10V; CP_Radial_D5.0mm_P2.00mm
J10: Controls cable to Main Board J10; PinHeader_2x20_P2.54mm_Vertical
J11: PJ-102AH | 5V ONLY, center +; BarrelJack_CUI_PJ-102AH_Horizontal
J20: TSW-120-07-L-D - DISPLAYS; PinHeader_2x20_P2.54mm_Vertical
J21: Backlight power to Main Board J21; PinHeader_1x03_P2.54mm_Vertical
Q1: IRLZ44N; TO-220-3_Vertical
R11, R12: 68k; R_Axial_DIN0207_L6.3mm_D2.5mm_P10.16mm_Horizontal
R13: 220; R_Axial_DIN0207_L6.3mm_D2.5mm_P10.16mm_Horizontal
R14, R21, R22, R23, R24: 100k; R_Axial_DIN0207_L6.3mm_D2.5mm_P10.16mm_Horizontal
U1: Teensy 4.1 - USB powered; Teensy41
U11, U12: MAX7219; DIP-24_W7.62mm
U13: 74AHCT125; DIP-14_W7.62mm

Connections:
/BACKLIGHT_GATE_5V: R13.1, U13.11
/BACKLIGHT_PWM_3V3: R24.1, U1.11 (9_OUT1C), U13.12
/BACKLIGHT_RETURN: J20.31, J20.32, J21.2, Q1.2 (D)
/CHANNEL_A: J10.16, U1.36 (14_A0_TX3_SPDIF_OUT)
/CHANNEL_B: J10.17, U1.37 (15_A1_RX3_SPDIF_IN)
/DIG1_0: J20.9, U11.2 (DIG_0)
/DIG1_1: J20.10, U11.11 (DIG_1)
/DIG1_2: J20.11, U11.6 (DIG_2)
/DIG1_3: J20.12, U11.7 (DIG_3)
/DIG1_4: J20.13, U11.3 (DIG_4)
/DIG1_5: J20.14, U11.10 (DIG_5)
/DIG2_0: J20.23, U12.2 (DIG_0)
/DIG2_1: J20.24, U12.11 (DIG_1)
/DISPLAY_CHAIN: U11.24 (DOUT), U12.1 (DIN)
/DISP_CLK_3V3: R22.1, U1.35 (13_SCK_LED), U13.5
/DISP_CLK_5V: U11.13 (CLK), U12.13 (CLK), U13.6
/DISP_DATA_3V3: R21.1, U1.13 (11_MOSI_CTX1), U13.2
/DISP_DATA_5V: U11.1 (DIN), U13.3
/DISP_LOAD_3V3: R23.1, U1.12 (10_CS_MQSR), U13.9
/DISP_LOAD_5V: U11.12 (LOAD), U12.12 (LOAD), U13.8
/FREQ1_A: J10.6, U1.2 (0_RX1_CRX2_CS1)
/FREQ1_B: J10.7, U1.3 (1_TX1_CTX2_MISO1)
/FREQ2_A: J10.8, U1.4 (2_OUT2)
/FREQ2_B: J10.9, U1.5 (3_LRCLK2)
/FREQ3_A: J10.10, U1.6 (4_BCLK2)
/FREQ3_B: J10.11, U1.7 (5_IN2)
/FREQ4_A: J10.12, U1.8 (6_OUT1D)
/FREQ4_B: J10.13, U1.9 (7_RX2_OUT1A)
/FREQ5_A: J10.14, U1.10 (8_TX2_IN1)
/FREQ5_B: J10.15, U1.14 (12_MISO_MQSL)
/GND: C11.2, C12.2, C13.2, C14.2, C15.2, J10.1, J10.32, J11.2, J20.27, J20.28, J21.3, Q1.3 (S), R14.2, R21.2, R22.2, R23.2, R24.2, U1.1 (GND), U1.34 (GND), U1.47 (GND), U1.52 (GND), U1.58 (GND), U1.59 (GND), U1.64 (GND), U11.4 (GND), U11.9 (GND), U12.4 (GND), U12.9 (GND), U13.1, U13.4, U13.7 (GND), U13.10, U13.13
/ISET1: R11.2, U11.18 (ISET)
/ISET2: R12.2, U12.18 (ISET)
/LED_5V: C11.1, C12.1, C13.1, C14.1, C15.1, J11.1, J20.29, J20.30, J21.1, R11.1, R12.1, U11.19 (V+), U12.19 (V+), U13.14 (VCC)
/LOAD: J10.29, U1.19 (27_A13_SCK1)
/MAIN_POS1: J10.20, U1.40 (18_A4_SDA)
/MAIN_POS2: J10.21, U1.41 (19_A5_SCL)
/MAIN_POS3: J10.22, U1.42 (20_A6_TX5_LRCLK1)
/MAIN_POS4: J10.23, U1.43 (21_A7_RX5_BCLK1)
/MOSFET_GATE: Q1.1 (G), R13.2, R14.1
/PRESET_POS1: J10.24, U1.44 (22_A8_CTX1)
/PRESET_POS2: J10.25, U1.45 (23_A9_CRX1_MCLK1)
/PRESET_POS3: J10.26, U1.16 (24_A10_TX6_SCL2)
/SEG1_A: J20.1, U11.14 (SEG_A)
/SEG1_B: J20.2, U11.16 (SEG_B)
/SEG1_C: J20.3, U11.20 (SEG_C)
/SEG1_D: J20.4, U11.23 (SEG_D)
/SEG1_DP: J20.8, U11.22 (SEG_DP)
/SEG1_E: J20.5, U11.21 (SEG_E)
/SEG1_F: J20.6, U11.15 (SEG_F)
/SEG1_G: J20.7, U11.17 (SEG_G)
/SEG2_A: J20.15, U12.14 (SEG_A)
/SEG2_B: J20.16, U12.16 (SEG_B)
/SEG2_C: J20.17, U12.20 (SEG_C)
/SEG2_D: J20.18, U12.23 (SEG_D)
/SEG2_DP: J20.22, U12.22 (SEG_DP)
/SEG2_E: J20.19, U12.21 (SEG_E)
/SEG2_F: J20.20, U12.15 (SEG_F)
/SEG2_G: J20.21, U12.17 (SEG_G)
/SQL: J10.28, U1.18 (26_A12_MOSI1)
/STATUS: J10.31, U1.21 (29_TX7)
/TEST_DISPLAY: J10.30, U1.20 (28_RX7)
/TONE: J10.27, U1.17 (25_A11_RX6_SDA2)
/VOL_A: J10.18, U1.38 (16_A2_RX4_SCL1)
/VOL_B: J10.19, U1.39 (17_A3_TX4_SDA1)

Notes on the sheet:
ARC-164 Power Driver Board: USB Teensy 4.1, display drivers, 5V distribution and backlight dimming
Teensy powered by USB. External regulated 5V feeds LEDs/MAX7219 only. VIN/VUSB are not joined to external 5V.
J20 cable goes directly to the unchanged LED Subboard. J10 goes to Main Board controls. J21 feeds Main Board backlights.
DCS-BIOS: MAX7219 intensity controls display brightness; GPIO9 PWM controls panel backlighting.
MAIN/PRESET use direct grounded contacts, no resistor ladders. Enable internal pull-ups for all 26 control GPIO inputs.
GPIO assignment is a new ARC-164 draft; firmware must be updated to match GPIO-Assignments.json.
19 green backlight LEDs and individual 330 ohm series resistors are on Main Board; physical clearance and brightness need prototype testing.
J20 DISPLAY ONLY: 40-pin 2.54mm IDC cable, 6in. Pins 1-32 retain existing assignments; 33-40 NC. Key toward PCB top edge. Label DISPLAY / J20; J10 is CONTROLS. Plain headers are not mechanically keyed.

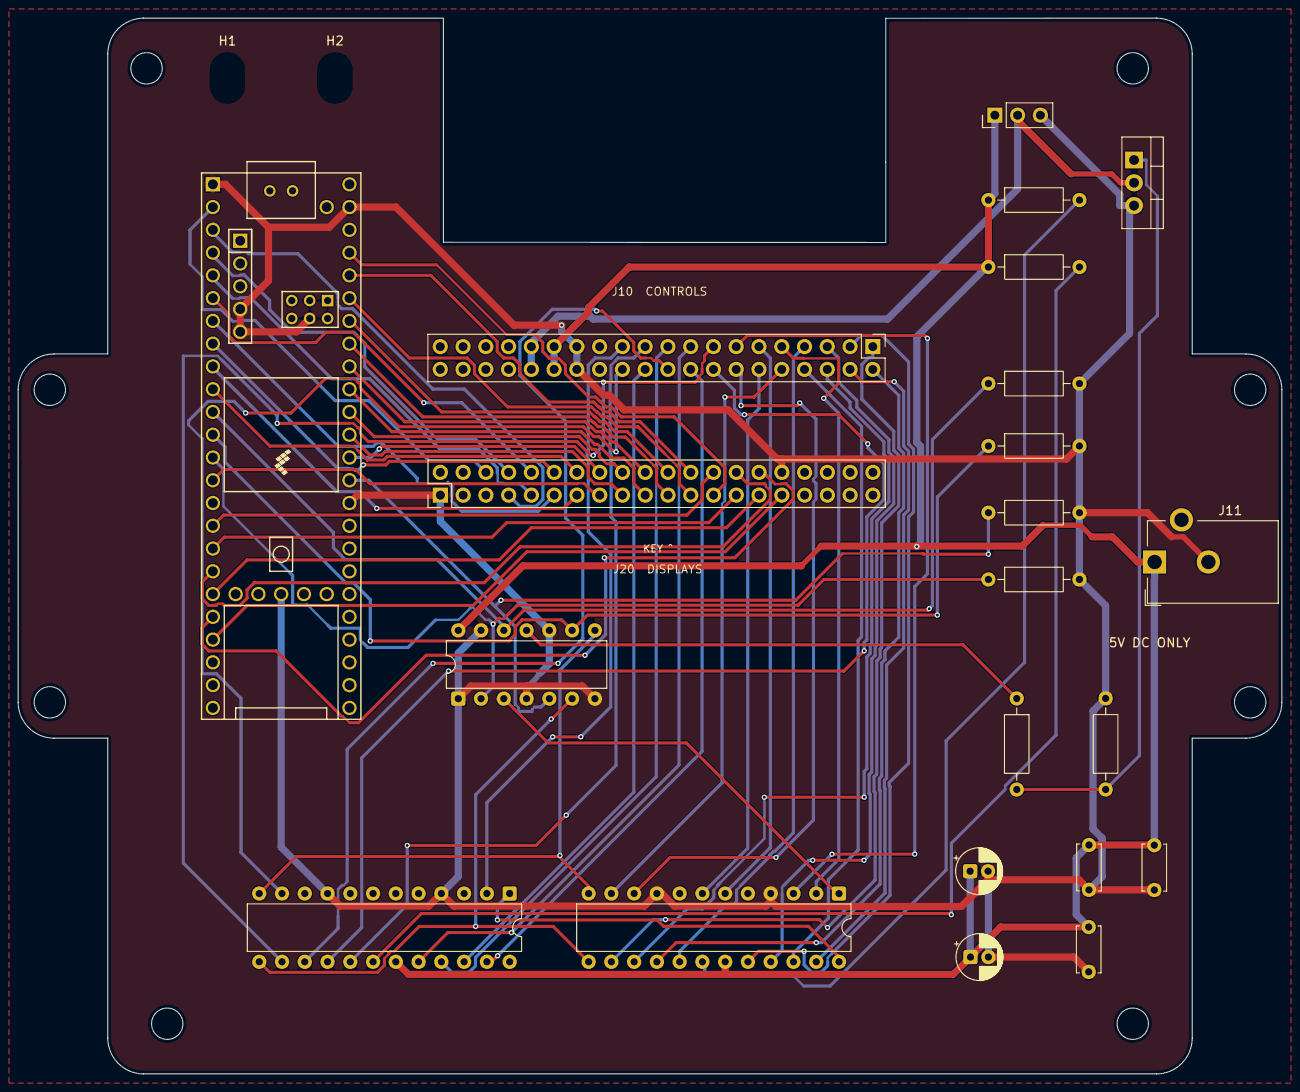
[picture p41: board Power Driver Board.kicad_pcb from above]

Board: 2 copper layers, 141.0 x 117.8 mm, 24 parts (0 on the bottom side), 65 nets.

Other parts of the board:
H1, H2: USB strain relief 3.2x5mm slot; USB_Strain_Relief_Slot_3.2x5mm
