dgdimick/ARC-164-DCS-Display/PCBs/Rotary Encoders/ARC-164 Encoders.kicad_pcb

## KiCad design PCBs/Rotary Encoders/ARC-164 Encoders.kicad_pcb (2026-11-01)

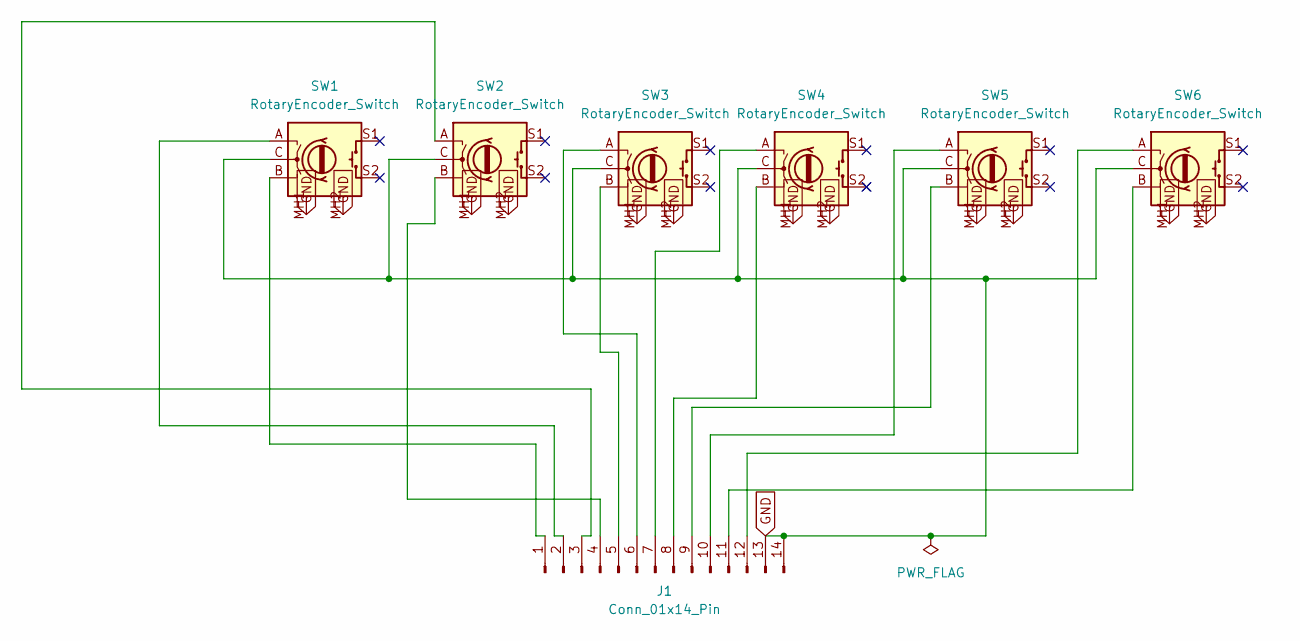
[picture p42: schematic ARC-164 Encoders.kicad_sch, ARC-164 Encoder PCB]

Parts:
J1: Conn_01x14_Pin; PinHeader_1x14_P2.54mm_Vertical
SW1, SW2, SW3, SW4, SW5, SW6: RotaryEncoder_Switch; PEC11H4220FS0024

Connections:
GND: J1.13, J1.14, SW1.C, SW1.MH1 (CASE), SW1.MH2 (CASE), SW2.C, SW2.MH1 (CASE), SW2.MH2 (CASE), SW3.C, SW3.MH1 (CASE), SW3.MH2 (CASE), SW4.C, SW4.MH1 (CASE), SW4.MH2 (CASE), SW5.C, SW5.MH1 (CASE), SW5.MH2 (CASE), SW6.C, SW6.MH1 (CASE), SW6.MH2 (CASE)
unnamed: J1.1, SW1.B
unnamed: J1.2, SW1.A
unnamed: J1.3, SW2.A
unnamed: J1.4, SW2.B
unnamed: J1.5, SW3.B
unnamed: J1.6, SW3.A
unnamed: J1.7, SW4.A
unnamed: J1.8, SW4.B
unnamed: J1.9, SW5.B
unnamed: J1.10, SW5.A
unnamed: J1.11, SW6.B
unnamed: J1.12, SW6.A

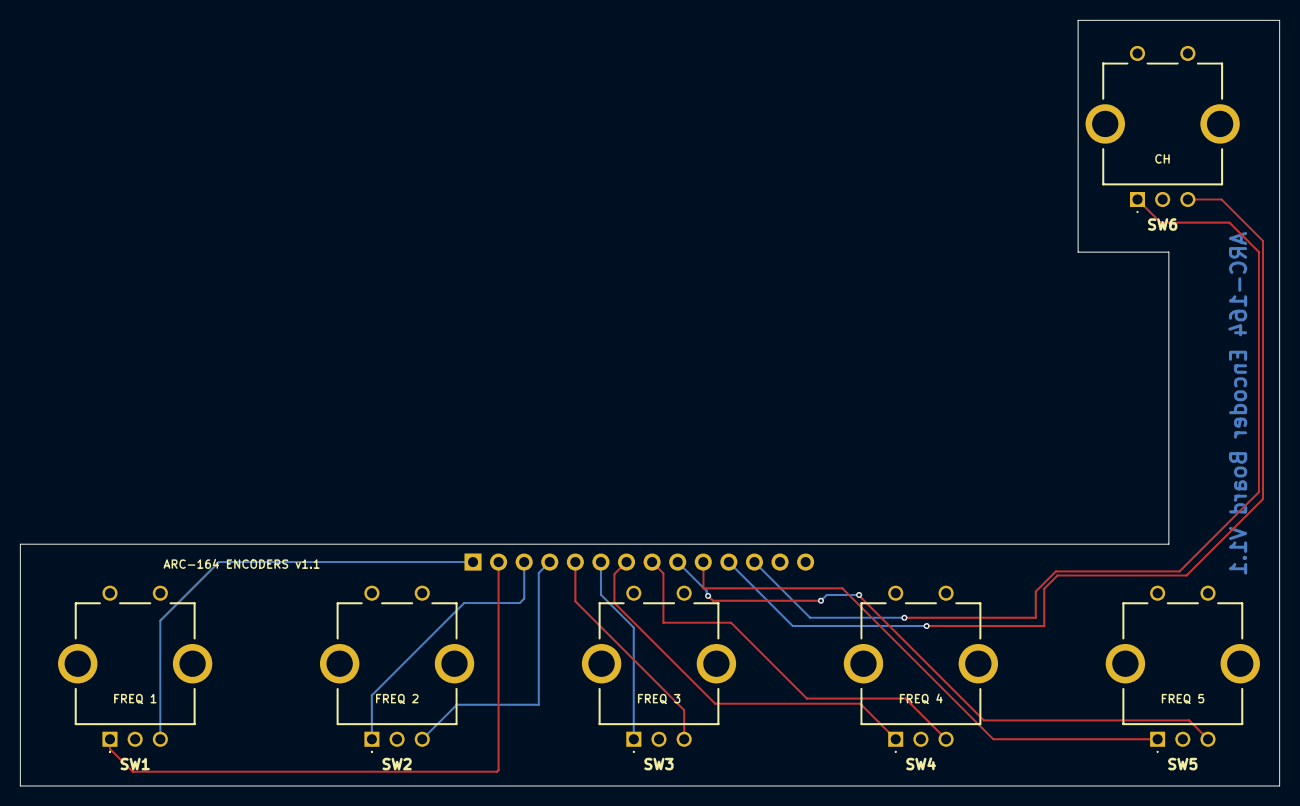
[picture p43: board ARC-164 Encoders.kicad_pcb from above]

Board: 2 copper layers, 125.0 x 76.0 mm, 7 parts (1 on the bottom side), 13 nets.
