dgdimick/ARC-164-DCS-Display/(commit log)

2026-10-30 Document planned six-encoder ARC-164 PCB
2026-10-30 Explain Teensy 4.1 controller choice and Due cost comparison
2026-10-30 Specify dedicated Teensy 4.1 for each radio and remove shared-controller plan
2026-10-30 Add visible Mountain Time last-updated timestamp
2026-10-30 Add Teensy versus classic Arduino clock-speed comparison
2026-10-30 Explain consistent Teensy 4.1 choice across radio projects
2026-10-30 Include processor speed in Teensy versus Nano decision
2026-10-30 Bold processor speeds in Teensy choice explanation
2026-10-30 Bold Nano and Teensy prices in controller explanation
2026-10-30 Link to shared Teensy controller explanation
2026-10-30 Explain sharing one Teensy USB connection across smaller panels
2026-10-30 Explain powered USB hubs as the preferred cockpit expansion approach
2026-10-30 List purchased powered USB hubs for radio and future cockpit panels
2026-10-30 Link to the shared USB connections and powered hubs page
2026-10-31 Explain planned through-hole component choice
2026-10-31 Add assembly pictures to remaining work
2026-10-31 Link ARC-210 PCB and printed-parts offers with explicit project scope
2026-10-31 Clarify ARC-164 and ARC-186 have no published printed parts yet
2026-10-31 Document six-encoder PCB findings without distributing faceplate drawing
2026-10-31 Publish ARC-164 encoder PCB and schematic draft with validation reports
2026-10-31 Exclude local KiCad session settings from encoder project
2026-10-31 Update encoder publication status and remaining clearance and test-fit work
2026-10-31 Add ARC-164 Encoder PCB 3D picture to project documentation
2026-10-31 Publish ARC-164 encoder PCB and schematic v1.0 after fresh checks
2026-11-01 Fix isolated copper zone and publish ARC-164 encoder PCB v1.1
2026-11-01 Simplify encoder README opening paragraph
2026-11-01 Add disclaimer and license links to encoder PCB README
2026-11-01 Show newest encoder PCB version first in history
2026-11-01 Keep licensing in main README instead of PCB documentation
2026-11-01 Show only current encoder PCB version in README
2026-11-01 List current boards in PCB overview and restore encoder version history
2026-11-01 Link current PCB overview from main README
2026-11-01 Update active ARC-164 status while awaiting ARC-210 PCBs
2026-11-01 Remove waiting-for-panels and board-arrival wording
2026-11-01 Document channel encoder choice instead of costly 20-position switch
2026-11-01 Document MAIN and PRESET rotary switch choices
2026-11-01 Correct OLED pin header description
2026-11-01 Add preset-channel OLED plan and both red filters
2026-11-01 Note button mockups and single-TFT clearance checks
2026-11-02 Explain channel encoder choice over costly continuous rotary switch
2026-11-02 Explain component supplier choices and substitute PCB fit
2026-11-02 Plan three four-digit LED blocks with pending fit and clearance checks
2026-11-02 Plan long shaft A12515RNCQ switches and ladders directly on Main PCB
2026-11-02 Clarify switch nuts and alignment holes provide mechanical support
2026-11-02 Document TONE and SQL toggle switch types
2026-11-02 Document 2/3/A rotary switch with matching shaft length
2026-11-02 Plan reused rotary switch PCB and five-encoder revision
2026-11-02 Document proposed staggered frequency-switch mounting
2026-11-02 Clarify shaft trimming after staggered mounting depths are set
2026-11-02 Specify upper and lower PCB shaft arrangement
2026-11-02 Document alternating frequency-switch shaft plan
2026-11-02 Plan printed guides for both frequency-switch shaft diameters
2026-11-02 Plan printed shaft cutting guide after mounting checks
2026-11-02 Add clickable staggered PCB mounting concept drawing
2026-11-03 Select 30 mm PEC11R encoder for VOL
2026-11-03 Record short-shaft frequency fit-check switch selection
2026-11-03 Record 13 mm deep socket assembly tool
2026-11-03 Update shaft-length plan and retire superseded frequency lengths
2026-11-03 Correct ARC-164 frequency and VOL shaft lengths
2026-11-03 Recommend deep-well sockets for switch and encoder nuts
2026-11-03 Set ARC-164 FREQ 2 and 4 planned shafts to 44 mm
2026-11-03 Replace example mounting drawing with KiCad fit-check picture
2026-11-03 Remove outdated shaft reference-model paragraph
2026-11-03 Remove superseded 2/3/A rotary switch section
2026-11-03 Remove superseded encoder PCB publication and planning
2026-11-03 Remove previous VOL encoder comparison paragraph
2026-11-03 Simplify ARC-164 README and consolidate mounting notes
2026-11-03 Select 38.1 mm frequency switches and extended knobs for FREQ 2 and 4
2026-11-03 Plan display daughterboard on standoffs and track TONE SQL selection
2026-11-03 Record ARC-164 toggle switch costs
2026-11-03 Include Teensy and shipping in ARC-164 running costs
2026-11-03 Note pending VOL encoder order and cost
2026-11-03 Remove split-level switch plan and return to frequency encoders
2026-11-03 Explain frequency switch fit limitation in PC Flights panel
2026-11-03 Align ARC-164 README with frequency encoder plan
2026-11-03 Keep frequency encoders in future ARC-164 versions
2026-11-03 Align PCB documentation with encoder-only frequency controls
2026-11-03 Note alignment slots required for frequency rotary switches
2026-11-03 Standardize frequency encoder decision across ARC-164 notes
2026-11-03 Add MAIN and PRESET shaft-height preview matched to FREQ3
2026-11-03 Revert MAIN and PRESET shaft-height preview update
2026-11-03 Clarify MAIN and PRESET parts, stop settings and PCB-to-tip shaft trimming
2026-11-03 Select shorter A12505RNCQ switches for MAIN and PRESET
2026-11-03 Clarify MAIN and PRESET use the same rotary switch
2026-11-03 Add DigiKey rotary-control order sheet and align VOL encoder selection
2026-11-03 Add ten QBSLDIW301GR LED digits to DigiKey order sheet
2026-11-03 Correct A11015RNCQ purchase notes: wrong ten-position switches
2026-11-03 Clarify unwanted switches depend on DigiKey cancellation outcome
2026-11-03 Reserve A11015RNCQ switches for ARC-210 V2 if cancellation fails
2026-11-03 Include rotary encoder design and rerouting in work item 2
2026-11-03 Source 30 mm PEC11R encoders from Mouser and refresh order sheet
2026-11-04 Switch LED order to Mouser SC36-11SURKWA and record DigiKey cancellation outcome
2026-11-04 Align display plan and work list with Mouser SC36-11SURKWA LEDs
2026-11-04 Update display LED selection
2026-11-04 Add green backlight LED order quantities for ARC-164 and ARC-210
2026-11-04 Clarify backlight LED counts are provisional pending layout
2026-11-04 Record PC Flights modified-panel request and pending rotary-switch option
2026-11-04 Note LED display work continues while awaiting PC Flights
2026-11-06 Continue ARC-164 encoder build and defer rotary-switch version until after ARC-186 and ARC-210 v2.0
2026-11-06 Add USB-C to Micro-B data adapter cable to panel parts information
2026-11-07 Add regulated 5V power supply to ARC-164 parts list
2026-11-07 Document November 7 power jack and supply update
2026-11-07 Add J11 power jack and Mouser link to parts list
2026-11-07 Add IC sockets and removable Teensy header recommendations
2026-11-07 Add sub-board front and back images and socket update
2026-11-07 Add Main Board front and back 3D images
2026-11-07 Add Power Board front 3D image
2026-11-07 Add Main Board resistor and LED assembly order
2026-11-07 Install Main Board rear connector before front components
2026-11-07 Add LED Sub-Board assembly order and orientation checks
2026-11-07 Add shortest-components-first assembly tip
2026-11-07 Add six-inch switch lead assembly instructions
2026-11-07 Clarify switch wire routing and rear solder connections
2026-11-07 Note planned build photos in assembly instructions
2026-11-07 Publish Version 1.0 prototypes of all three ARC-164 PCBs
2026-11-07 Make ARC-164 prototype introduction and release wording friendlier
2026-11-08 Note pending new display spacing fit test in PCB overview
2026-11-08 Document 18 mm panel mounting stack using nut and standoff
2026-11-08 Add panel mounting spacing to PCB overview
2026-11-08 Set LED Sub-Board mounting spacing to 11 mm
2026-11-08 Specify ten Power Board standoffs and board stack orientation
2026-11-08 Clarify four Sub-Board mounts and downward Power Board components
2026-11-08 Add consistent mounting notes to individual board READMEs
2026-11-08 Clarify 6 mm display bodies and retain 11 mm spacing pending fit test
2026-11-08 Replace Sub-Board standoffs with four 8 mm nut-and-washer mounts
2026-11-08 Record successful 8 mm Sub-Board mounting fit test
2026-11-08 Clarify successful Sub-Board fit in Main Board testing status
2026-11-08 Separate passed mounting stack test from pending LED gap fit test
2026-11-08 Update pending LED spacing test to 0.75 mm gaps
2026-11-08 Document shifted FREQ and channel LEDs pending new mockup fit test
2026-11-08 Document LED Sub-Board v1.1 development and pending fit test
2026-11-08 Publish fit-tested LED Sub Board v1.1 and mockup STL
2026-11-08 Correct panel-to-Main-Board spacing and note possible adjustment
2026-11-08 Hold PCB ordering pending J20 cable connector clearance redesign
2026-11-08 Withdraw Main and LED Sub Board downloads pending replacement fit tests
2026-11-09 Publish Main Board v1.1 with Sub Board compatibility warning
2026-11-09 Clarify Main Board v1.1 compatibility throughout documentation
2026-11-09 Track matching Sub Board completion and LED/J20 fit tests
2026-11-09 Add matching Sub Board completion checklist to PCB overview
2026-11-09 Require channel LED alignment and J20 clearance checks before Sub Board publication
2026-11-09 Record latest 0.5mm channel LED adjustment and pending Sub Board checks
2026-11-09 Align remaining Sub Board documentation with 0.5mm left shift and pending checks
2026-11-10 Document channel LEDs up 0.5mm and J20 up 2mm pending fit tests
2026-11-10 Align Sub Board docs with channel up 0.5mm and J20 up 2mm
2026-11-10 Explain off-center J10 placement on Main Board v1.1
2026-11-10 Publish Main Board v1.2 with revised J10 placement and aligned switch pads
2026-11-10 Note filament delay and PLA temperature test before Sub Board reprint
2026-11-10 Record PC Flights larger-hole ARC-164 panel availability on request
2026-11-10 Add ARC-186 existing-panel and tentative multilevel switch plan to related projects
2026-11-10 Prioritize ARC-164 PCB completion then a design break and ARC-210 testing
2026-11-11 Publish fit-tested LED Sub Board v1.2 for Main Board v1.2
2026-11-11 Clarify published Sub Board v1.2 compatibility and historical withdrawal headings
2026-11-11 Clarify MAIN and PRESET GPIO wiring
2026-11-11 Document MAIN and PRESET connector and GPIO pinout
2026-11-11 Document ARC-164 MOSFET backlight dimming
2026-11-11 Document Windows USB device naming
2026-11-12 Document layer height and support-free knob printing
2026-11-12 Add ARC-164 rotary encoder shaft adapters to print plans
2026-11-12 Document free printing help for ARC-164 and ARC-186 builders
2026-11-13 Add beginner soldering tips
2026-11-14 Document PowerShell script execution troubleshooting
2026-11-14 Announce ARC-164 PCB prototypes and next steps
